thereprocase/kraken-remix-ogAMS/rings/brand-sizes/README.md

# Pentagon pairs for specific cardboard spools

Matched gear-side and cap-side centering rings for spool holes that fall between the 1 mm [stock sizes](../stock-sizes/README.md). They use the same pentagon design and the same generator; a fractional size keeps the holder bore and snap ribs of the next smaller stock ring. The five corners bite into cardboard; for hard plastic hubs use the [spring pairs](../hard-spool/README.md).

**Flange sets.** *Normal*: 2.2 mm gear-side flange and 0.6 mm cap-side lip. *Skinny*: 0.4 mm on both sides, for holders where the extra 2.0 mm of stack does not fit. humebeam's original 0.4 mm cap lip tends to break during bed removal and handling, which is why normal thickens it. The spigot of each side rises by the added base thickness, so it still inserts as deep as the stock ring.

| Nominal hole · set | Gear side | Cap side |
|---|---|---|
| 53.4 mm (Elegoo Rapid PETG cardboard spool) · normal | [3MF](models/kraken-spool-ring-53.4-mm-pentagon-gear-side-2.2mm-flange.3mf) · [STL](models/kraken-spool-ring-53.4-mm-pentagon-gear-side-2.2mm-flange.stl) · [STEP.gz](https://github.com/thereprocase/kraken-remix-ogAMS/releases/download/rings-2026-10-28/kraken-spool-ring-53.4-mm-pentagon-gear-side-2.2mm-flange.step.gz) | [3MF](models/kraken-spool-ring-53.4-mm-pentagon-cap-side-0.6mm-lip.3mf) · [STL](models/kraken-spool-ring-53.4-mm-pentagon-cap-side-0.6mm-lip.stl) · [STEP.gz](https://github.com/thereprocase/kraken-remix-ogAMS/releases/download/rings-2026-10-28/kraken-spool-ring-53.4-mm-pentagon-cap-side-0.6mm-lip.step.gz) |
| 53.4 mm · skinny | [3MF](models-skinny/kraken-spool-ring-53.4-mm-pentagon-gear-side-0.4mm-flange.3mf) · [STL](models-skinny/kraken-spool-ring-53.4-mm-pentagon-gear-side-0.4mm-flange.stl) · [STEP.gz](https://github.com/thereprocase/kraken-remix-ogAMS/releases/download/rings-2026-10-28/kraken-spool-ring-53.4-mm-pentagon-gear-side-0.4mm-flange.step.gz) | [3MF](models-skinny/kraken-spool-ring-53.4-mm-pentagon-cap-side-0.4mm-lip.3mf) · [STL](models-skinny/kraken-spool-ring-53.4-mm-pentagon-cap-side-0.4mm-lip.stl) · [STEP.gz](https://github.com/thereprocase/kraken-remix-ogAMS/releases/download/rings-2026-10-28/kraken-spool-ring-53.4-mm-pentagon-cap-side-0.4mm-lip.step.gz) |

The 55.5 mm Polymaker pair is on the [rings page](../README.md). Geometry checks: [normal](VALIDATION.json), [skinny](VALIDATION-skinny.json); each also covers the 55.5 mm pair, built in the same run. Physical fit is reported only where the table on the rings page says it was measured.
