thereprocase/kraken-remix-ogAMS/rings/round-flanges/README.md

# Round ring pairs

The earlier round centering rings: humebeam's round outer profile, with the 0.4 mm lip thickened per flange set. The gear-side flange reaches **20 mm radially beyond the hole**, wider than the later [pentagon family](../stock-sizes/README.md) with its 10.25 mm reach. The cap side keeps the lip's 2.5 mm reach. For cardboard spools the pentagon pairs grip better; for hard plastic spools use the [spring pairs](../hard-spool/README.md).

**Flange sets.** *Normal*: 2.2 mm gear-side flange and 0.6 mm cap-side lip. *Skinny*: 0.4 mm on both sides (the skinny cap side is humebeam's ring unchanged). humebeam's 0.4 mm cap lip tends to break during bed removal and handling, which is why normal thickens it.

Choose by measured spool hole. The family has not been physically fit-tested across every size. STL coordinates retain the original source placement: centre the part and move its flat flange underside onto the bed in your slicer. The model files do not contain print settings.

| Nominal hole | Normal set | Skinny set |
|---|---|---|
| 45 mm | [gear 2.2 mm](models/kraken-spool-ring-45-mm-round-gear-side-2.2mm-flange.stl) · [cap 0.6 mm](models/kraken-spool-ring-45-mm-round-cap-side-0.6mm-lip.stl) | [gear 0.4 mm](models-skinny/kraken-spool-ring-45-mm-round-gear-side-0.4mm-flange.stl) · [cap 0.4 mm](models-skinny/kraken-spool-ring-45-mm-round-cap-side-0.4mm-lip.stl) |
| 46 mm | [gear 2.2 mm](models/kraken-spool-ring-46-mm-round-gear-side-2.2mm-flange.stl) · [cap 0.6 mm](models/kraken-spool-ring-46-mm-round-cap-side-0.6mm-lip.stl) | [gear 0.4 mm](models-skinny/kraken-spool-ring-46-mm-round-gear-side-0.4mm-flange.stl) · [cap 0.4 mm](models-skinny/kraken-spool-ring-46-mm-round-cap-side-0.4mm-lip.stl) |
| 47 mm | [gear 2.2 mm](models/kraken-spool-ring-47-mm-round-gear-side-2.2mm-flange.stl) · [cap 0.6 mm](models/kraken-spool-ring-47-mm-round-cap-side-0.6mm-lip.stl) | [gear 0.4 mm](models-skinny/kraken-spool-ring-47-mm-round-gear-side-0.4mm-flange.stl) · [cap 0.4 mm](models-skinny/kraken-spool-ring-47-mm-round-cap-side-0.4mm-lip.stl) |
| 48 mm | [gear 2.2 mm](models/kraken-spool-ring-48-mm-round-gear-side-2.2mm-flange.stl) · [cap 0.6 mm](models/kraken-spool-ring-48-mm-round-cap-side-0.6mm-lip.stl) | [gear 0.4 mm](models-skinny/kraken-spool-ring-48-mm-round-gear-side-0.4mm-flange.stl) · [cap 0.4 mm](models-skinny/kraken-spool-ring-48-mm-round-cap-side-0.4mm-lip.stl) |
| 49 mm | [gear 2.2 mm](models/kraken-spool-ring-49-mm-round-gear-side-2.2mm-flange.stl) · [cap 0.6 mm](models/kraken-spool-ring-49-mm-round-cap-side-0.6mm-lip.stl) | [gear 0.4 mm](models-skinny/kraken-spool-ring-49-mm-round-gear-side-0.4mm-flange.stl) · [cap 0.4 mm](models-skinny/kraken-spool-ring-49-mm-round-cap-side-0.4mm-lip.stl) |
| 50 mm | [gear 2.2 mm](models/kraken-spool-ring-50-mm-round-gear-side-2.2mm-flange.stl) · [cap 0.6 mm](models/kraken-spool-ring-50-mm-round-cap-side-0.6mm-lip.stl) | [gear 0.4 mm](models-skinny/kraken-spool-ring-50-mm-round-gear-side-0.4mm-flange.stl) · [cap 0.4 mm](models-skinny/kraken-spool-ring-50-mm-round-cap-side-0.4mm-lip.stl) |
| 51 mm | [gear 2.2 mm](models/kraken-spool-ring-51-mm-round-gear-side-2.2mm-flange.stl) · [cap 0.6 mm](models/kraken-spool-ring-51-mm-round-cap-side-0.6mm-lip.stl) | [gear 0.4 mm](models-skinny/kraken-spool-ring-51-mm-round-gear-side-0.4mm-flange.stl) · [cap 0.4 mm](models-skinny/kraken-spool-ring-51-mm-round-cap-side-0.4mm-lip.stl) |
| 52 mm | [gear 2.2 mm](models/kraken-spool-ring-52-mm-round-gear-side-2.2mm-flange.stl) · [cap 0.6 mm](models/kraken-spool-ring-52-mm-round-cap-side-0.6mm-lip.stl) | [gear 0.4 mm](models-skinny/kraken-spool-ring-52-mm-round-gear-side-0.4mm-flange.stl) · [cap 0.4 mm](models-skinny/kraken-spool-ring-52-mm-round-cap-side-0.4mm-lip.stl) |
| 53 mm | [gear 2.2 mm](models/kraken-spool-ring-53-mm-round-gear-side-2.2mm-flange.stl) · [cap 0.6 mm](models/kraken-spool-ring-53-mm-round-cap-side-0.6mm-lip.stl) | [gear 0.4 mm](models-skinny/kraken-spool-ring-53-mm-round-gear-side-0.4mm-flange.stl) · [cap 0.4 mm](models-skinny/kraken-spool-ring-53-mm-round-cap-side-0.4mm-lip.stl) |
| 54 mm | [gear 2.2 mm](models/kraken-spool-ring-54-mm-round-gear-side-2.2mm-flange.stl) · [cap 0.6 mm](models/kraken-spool-ring-54-mm-round-cap-side-0.6mm-lip.stl) | [gear 0.4 mm](models-skinny/kraken-spool-ring-54-mm-round-gear-side-0.4mm-flange.stl) · [cap 0.4 mm](models-skinny/kraken-spool-ring-54-mm-round-cap-side-0.4mm-lip.stl) |
| 55 mm | [gear 2.2 mm](models/kraken-spool-ring-55-mm-round-gear-side-2.2mm-flange.stl) · [cap 0.6 mm](models/kraken-spool-ring-55-mm-round-cap-side-0.6mm-lip.stl) | [gear 0.4 mm](models-skinny/kraken-spool-ring-55-mm-round-gear-side-0.4mm-flange.stl) · [cap 0.4 mm](models-skinny/kraken-spool-ring-55-mm-round-cap-side-0.4mm-lip.stl) |
| 56 mm | [gear 2.2 mm](models/kraken-spool-ring-56-mm-round-gear-side-2.2mm-flange.stl) · [cap 0.6 mm](models/kraken-spool-ring-56-mm-round-cap-side-0.6mm-lip.stl) | [gear 0.4 mm](models-skinny/kraken-spool-ring-56-mm-round-gear-side-0.4mm-flange.stl) · [cap 0.4 mm](models-skinny/kraken-spool-ring-56-mm-round-cap-side-0.4mm-lip.stl) |
| 57 mm | [gear 2.2 mm](models/kraken-spool-ring-57-mm-round-gear-side-2.2mm-flange.stl) · [cap 0.6 mm](models/kraken-spool-ring-57-mm-round-cap-side-0.6mm-lip.stl) | [gear 0.4 mm](models-skinny/kraken-spool-ring-57-mm-round-gear-side-0.4mm-flange.stl) · [cap 0.4 mm](models-skinny/kraken-spool-ring-57-mm-round-cap-side-0.4mm-lip.stl) |
| 58 mm | [gear 2.2 mm](models/kraken-spool-ring-58-mm-round-gear-side-2.2mm-flange.stl) · [cap 0.6 mm](models/kraken-spool-ring-58-mm-round-cap-side-0.6mm-lip.stl) | [gear 0.4 mm](models-skinny/kraken-spool-ring-58-mm-round-gear-side-0.4mm-flange.stl) · [cap 0.4 mm](models-skinny/kraken-spool-ring-58-mm-round-cap-side-0.4mm-lip.stl) |
| 59 mm | [gear 2.2 mm](models/kraken-spool-ring-59-mm-round-gear-side-2.2mm-flange.stl) · [cap 0.6 mm](models/kraken-spool-ring-59-mm-round-cap-side-0.6mm-lip.stl) | [gear 0.4 mm](models-skinny/kraken-spool-ring-59-mm-round-gear-side-0.4mm-flange.stl) · [cap 0.4 mm](models-skinny/kraken-spool-ring-59-mm-round-cap-side-0.4mm-lip.stl) |
| 60 mm | [gear 2.2 mm](models/kraken-spool-ring-60-mm-round-gear-side-2.2mm-flange.stl) · [cap 0.6 mm](models/kraken-spool-ring-60-mm-round-cap-side-0.6mm-lip.stl) | [gear 0.4 mm](models-skinny/kraken-spool-ring-60-mm-round-gear-side-0.4mm-flange.stl) · [cap 0.4 mm](models-skinny/kraken-spool-ring-60-mm-round-cap-side-0.4mm-lip.stl) |
| 61 mm | [gear 2.2 mm](models/kraken-spool-ring-61-mm-round-gear-side-2.2mm-flange.stl) · [cap 0.6 mm](models/kraken-spool-ring-61-mm-round-cap-side-0.6mm-lip.stl) | [gear 0.4 mm](models-skinny/kraken-spool-ring-61-mm-round-gear-side-0.4mm-flange.stl) · [cap 0.4 mm](models-skinny/kraken-spool-ring-61-mm-round-cap-side-0.4mm-lip.stl) |
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
| 90 mm | [gear 2.2 mm](models/kraken-spool-ring-90-mm-round-gear-side-2.2mm-flange.stl) · [cap 0.6 mm](models/kraken-spool-ring-90-mm-round-cap-side-0.6mm-lip.stl) | [gear 0.4 mm](models-skinny/kraken-spool-ring-90-mm-round-gear-side-0.4mm-flange.stl) · [cap 0.4 mm](models-skinny/kraken-spool-ring-90-mm-round-cap-side-0.4mm-lip.stl) |
| 91 mm | [gear 2.2 mm](models/kraken-spool-ring-91-mm-round-gear-side-2.2mm-flange.stl) · [cap 0.6 mm](models/kraken-spool-ring-91-mm-round-cap-side-0.6mm-lip.stl) | [gear 0.4 mm](models-skinny/kraken-spool-ring-91-mm-round-gear-side-0.4mm-flange.stl) · [cap 0.4 mm](models-skinny/kraken-spool-ring-91-mm-round-cap-side-0.4mm-lip.stl) |
| 92 mm | [gear 2.2 mm](models/kraken-spool-ring-92-mm-round-gear-side-2.2mm-flange.stl) · [cap 0.6 mm](models/kraken-spool-ring-92-mm-round-cap-side-0.6mm-lip.stl) | [gear 0.4 mm](models-skinny/kraken-spool-ring-92-mm-round-gear-side-0.4mm-flange.stl) · [cap 0.4 mm](models-skinny/kraken-spool-ring-92-mm-round-cap-side-0.4mm-lip.stl) |
| 93 mm | [gear 2.2 mm](models/kraken-spool-ring-93-mm-round-gear-side-2.2mm-flange.stl) · [cap 0.6 mm](models/kraken-spool-ring-93-mm-round-cap-side-0.6mm-lip.stl) | [gear 0.4 mm](models-skinny/kraken-spool-ring-93-mm-round-gear-side-0.4mm-flange.stl) · [cap 0.4 mm](models-skinny/kraken-spool-ring-93-mm-round-cap-side-0.4mm-lip.stl) |
| 94 mm | [gear 2.2 mm](models/kraken-spool-ring-94-mm-round-gear-side-2.2mm-flange.stl) · [cap 0.6 mm](models/kraken-spool-ring-94-mm-round-cap-side-0.6mm-lip.stl) | [gear 0.4 mm](models-skinny/kraken-spool-ring-94-mm-round-gear-side-0.4mm-flange.stl) · [cap 0.4 mm](models-skinny/kraken-spool-ring-94-mm-round-cap-side-0.4mm-lip.stl) |
| 95 mm | [gear 2.2 mm](models/kraken-spool-ring-95-mm-round-gear-side-2.2mm-flange.stl) · [cap 0.6 mm](models/kraken-spool-ring-95-mm-round-cap-side-0.6mm-lip.stl) | [gear 0.4 mm](models-skinny/kraken-spool-ring-95-mm-round-gear-side-0.4mm-flange.stl) · [cap 0.4 mm](models-skinny/kraken-spool-ring-95-mm-round-cap-side-0.4mm-lip.stl) |

Bulk downloads: [normal set ZIP](https://github.com/thereprocase/kraken-remix-ogAMS/releases/download/rings-2026-10-28/kraken-spool-rings-round-normal-stl.zip) · [skinny set ZIP](https://github.com/thereprocase/kraken-remix-ogAMS/releases/download/rings-2026-10-28/kraken-spool-rings-round-skinny-stl.zip).

## Reproduction

[Validation](VALIDATION.json) checks all 204 meshes as single closed solids. From the repository root, using its CAD dependencies:

```sh
python rings/source/round_flange.py rings/source/reference round-build normal
python rings/source/round_flange.py rings/source/reference round-skinny-build skinny
```

The script remaps humebeam's mesh in place: heights 0–0.4 mm stretch to the new base thickness, everything above moves up by the difference, and gear-side lip vertices move outward to the 20 mm reach. It does not scale the holder bore radially. At 1.5 mm the same remap reproduces the earlier published gear-side files byte for byte apart from the STL header. Original meshes are attributed in the [source notes](../source/README.md). The changed flange does not by itself prove increased gear-to-body clearance.

Original design: **humebeam**; remix: **thereprocase**. [CC BY-NC 4.0](../../LICENSE.md).
