thereprocase/kraken-remix-ogAMS/reloadable-spool/renders/exploded.png

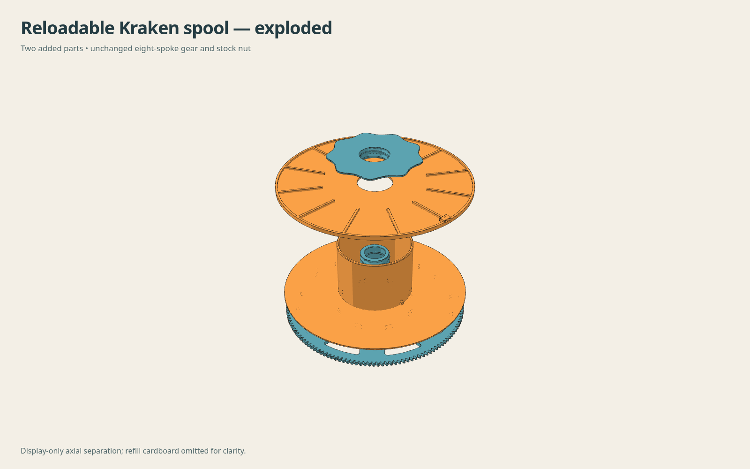
reloadable-spool/renders/exploded.png
