thereprocase/kraken-remix-ogAMS/models/left-body-standard_full.step

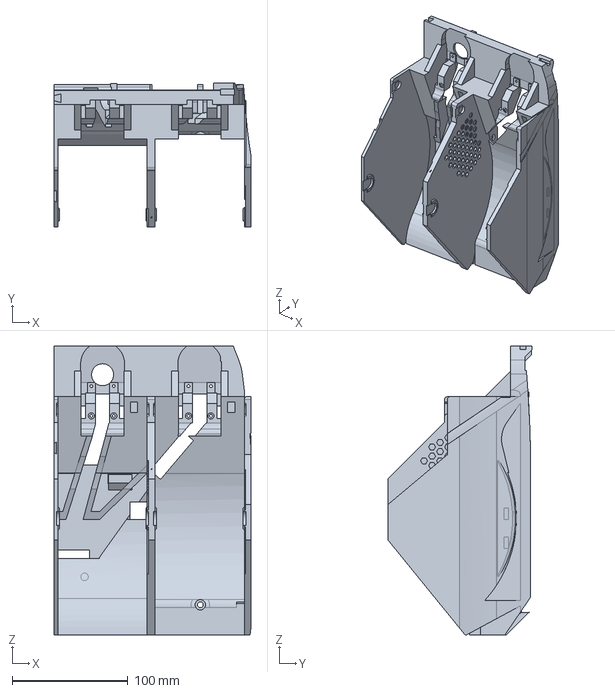
[picture p10: CAD file, 2026-10-16]
models/left-body-standard_full.step
170.2 x 124.8 x 249.9 mm
