thereprocase/kraken-remix-ogAMS/reloadable-spool/artifacts/assembly-reference-NOT-FOR-PRINT.3mf

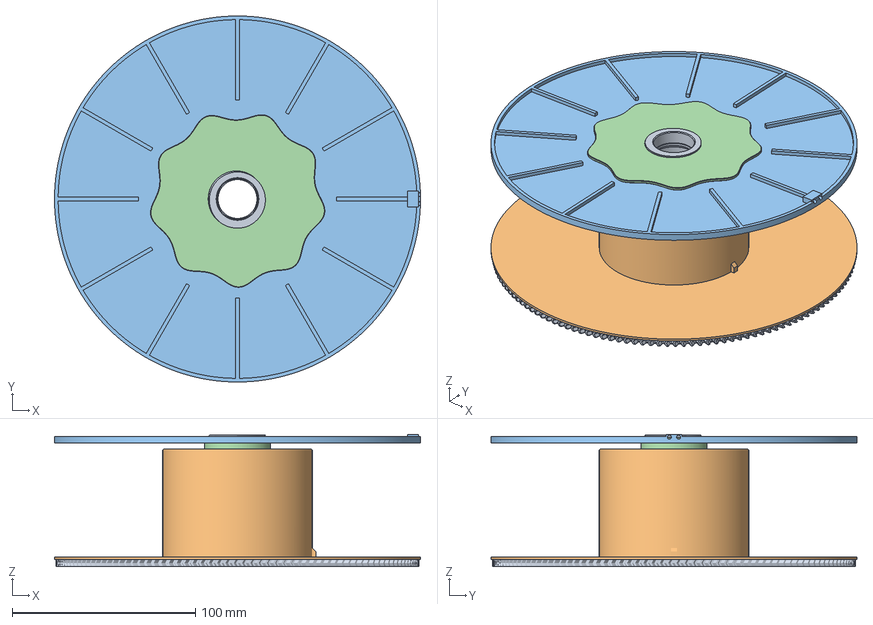
[picture p11: CAD file, 2026-10-17]
reloadable-spool/artifacts/assembly-reference-NOT-FOR-PRINT.3mf
200.0 x 200.0 x 72.4 mm
retained-eight-spoke-gear
backing-sleeve
removable-flange
retained-stock-nut
