thereprocase/kraken-remix-ogAMS/reloadable-spool/artifacts/added-parts-assembly.step

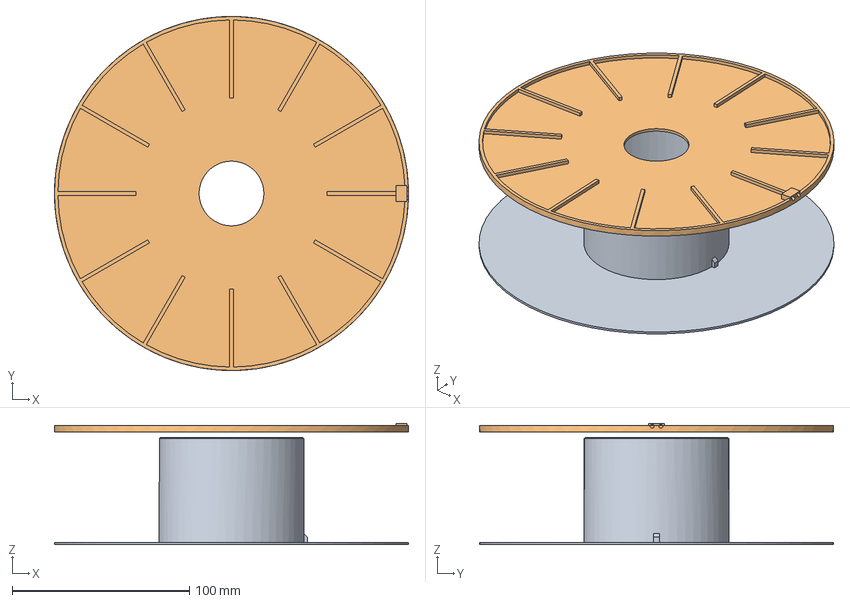
[picture p12: CAD file, 2026-10-17]
reloadable-spool/artifacts/added-parts-assembly.step
200.0 x 199.9 x 68.4 mm
