thereprocase/kraken-remix-ogAMS/prints/pctg-2026-10-28-v5/left-front-bar-v5-assembly.step

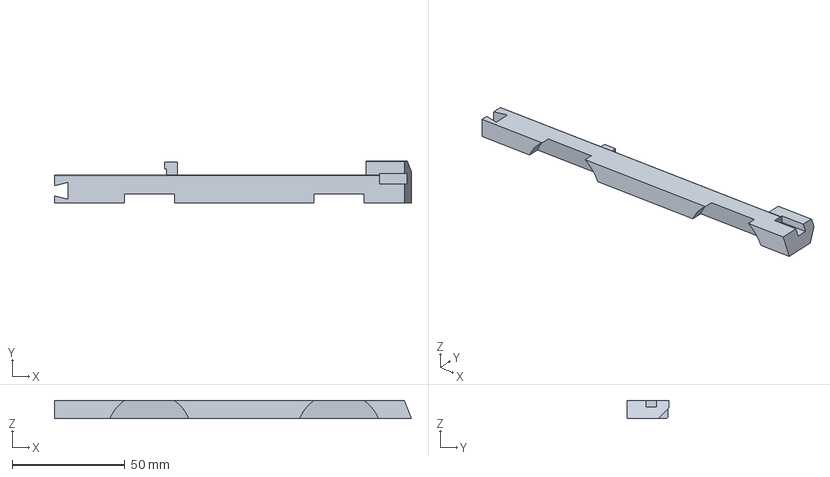
[picture p13: CAD file, 2026-10-28]
prints/pctg-2026-10-28-v5/left-front-bar-v5-assembly.step
158.1 x 18.7 x 8.00 mm
