thereprocase/kraken-remix-ogAMS/models/right-body-standard_full.step

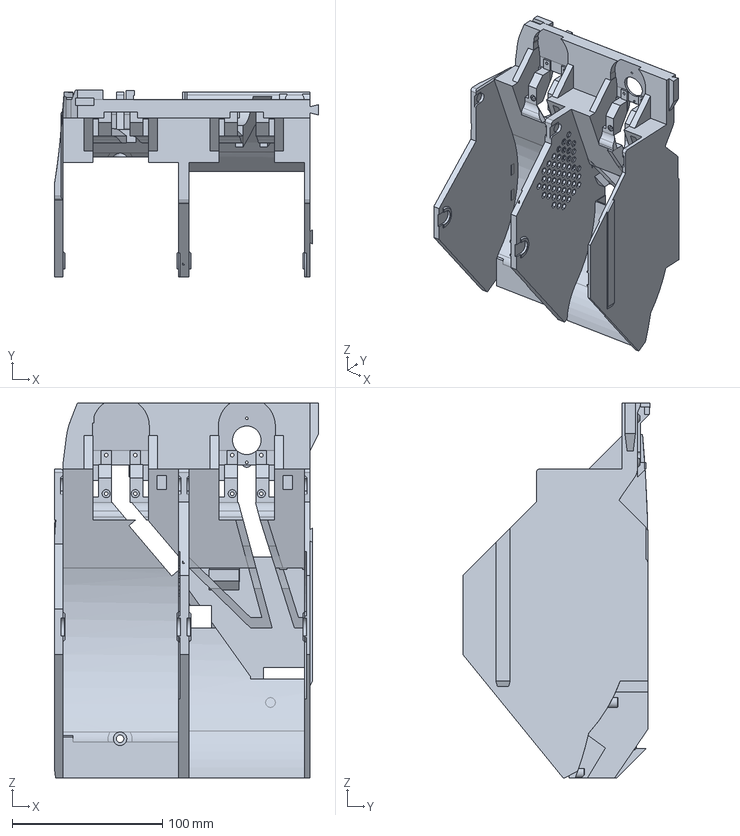
[picture p14: CAD file, 2026-10-16]
models/right-body-standard_full.step
176.1 x 124.8 x 249.9 mm
