thereprocase/kraken-remix-ogAMS/coupons/cut5_alignment84/artifacts/right_sockets_84_nominal.step

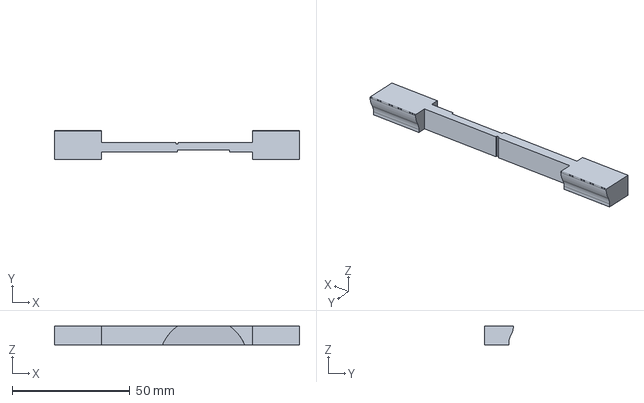
[picture p15: CAD file, 2026-10-16]
coupons/cut5_alignment84/artifacts/right_sockets_84_nominal.step
104.0 x 12.4 x 8.00 mm
