thereprocase/kraken-remix-ogAMS/coupons/cut5_fit/artifacts/key_common.step

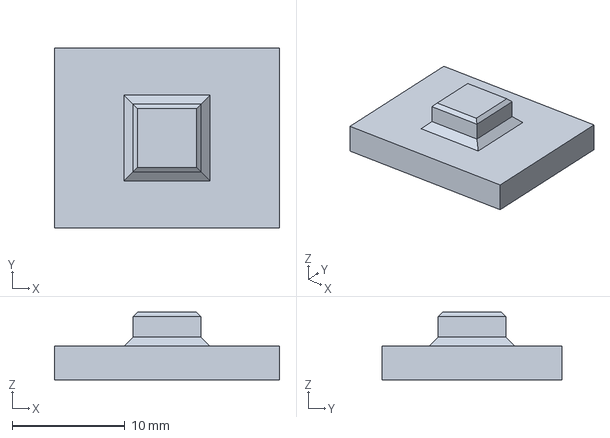
[picture p16: CAD file, 2026-10-16]
coupons/cut5_fit/artifacts/key_common.step
20.0 x 16.0 x 6.00 mm
