thereprocase/kraken-remix-ogAMS/gear/models/gear-spokes.3mf

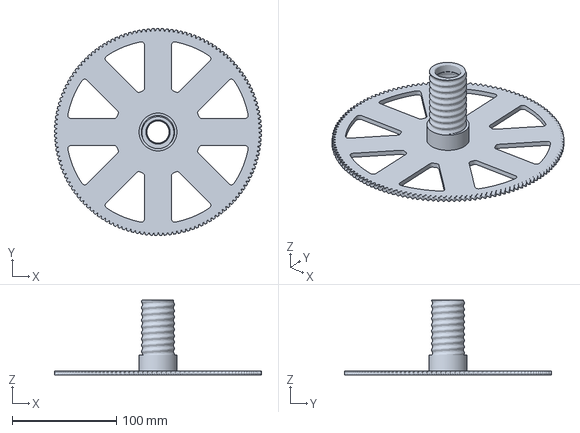
[picture p17: CAD file, 2026-10-15]
gear/models/gear-spokes.3mf
198.6 x 198.6 x 71.9 mm
