thereprocase/kraken-remix-ogAMS/models/right-body-standard_cut5.step

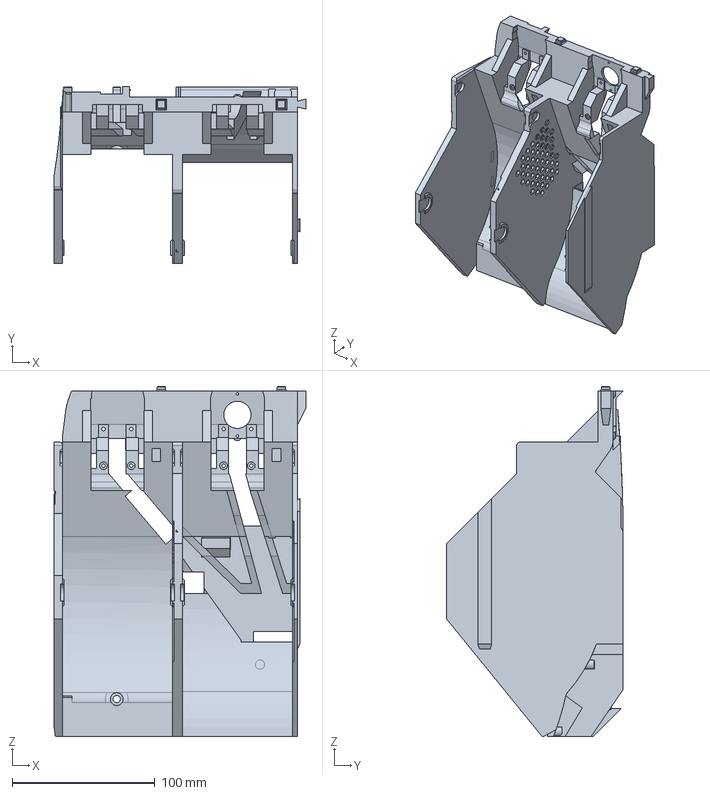
[picture p18: CAD file, 2026-10-16]
models/right-body-standard_cut5.step
176.1 x 123.8 x 244.9 mm
