thereprocase/kraken-remix-ogAMS/reloadable-spool/artifacts/removable-flange.step

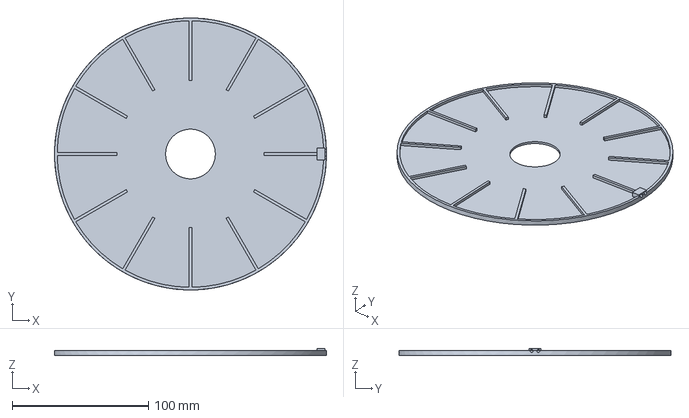
[picture p19: CAD file, 2026-10-17]
reloadable-spool/artifacts/removable-flange.step
200.0 x 200.0 x 4.80 mm
