thereprocase/kraken-remix-ogAMS/reloadable-spool/revisions/uniform-flange-6mm/artifacts/backing-sleeve-keyless-installed.step

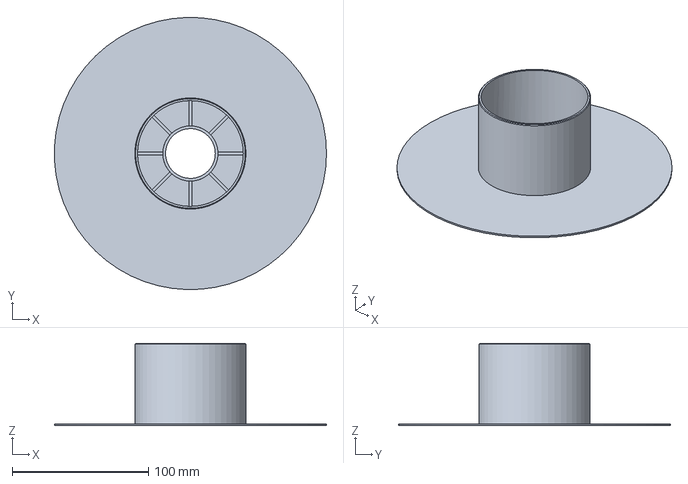
[picture p20: CAD file, 2026-10-17]
reloadable-spool/revisions/uniform-flange-6mm/artifacts/backing-sleeve-keyless-installed.step
199.9 x 199.9 x 60.4 mm
