thereprocase/kraken-remix-ogAMS/rings/brand-sizes/models-skinny/kraken-spool-ring-53.4-mm-pentagon-gear-side-0.4mm-flange.3mf

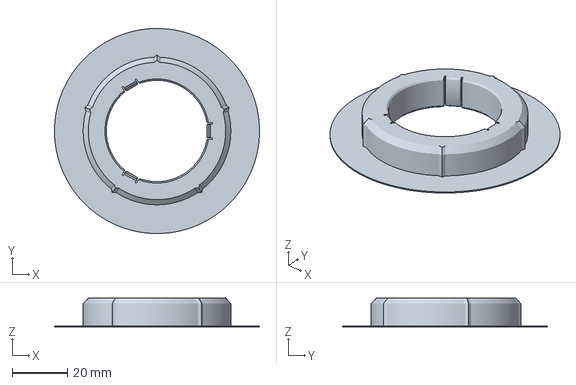
[picture p21: CAD file, 2026-10-28]
rings/brand-sizes/models-skinny/kraken-spool-ring-53.4-mm-pentagon-gear-side-0.4mm-flange.3mf
73.9 x 73.9 x 10.4 mm
