thereprocase/kraken-remix-ogAMS/rings/brand-sizes/models/kraken-spool-ring-53.4-mm-pentagon-cap-side-0.6mm-lip.3mf

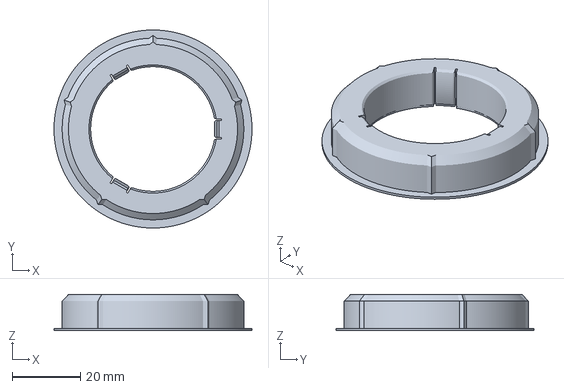
[picture p22: CAD file, 2026-10-28]
rings/brand-sizes/models/kraken-spool-ring-53.4-mm-pentagon-cap-side-0.6mm-lip.3mf
58.0 x 58.0 x 10.6 mm
