thereprocase/kraken-remix-ogAMS/rings/hard-spool/models-skinny/kraken-spool-ring-52.1-mm-spring-cap-side-0.4mm-lip.3mf

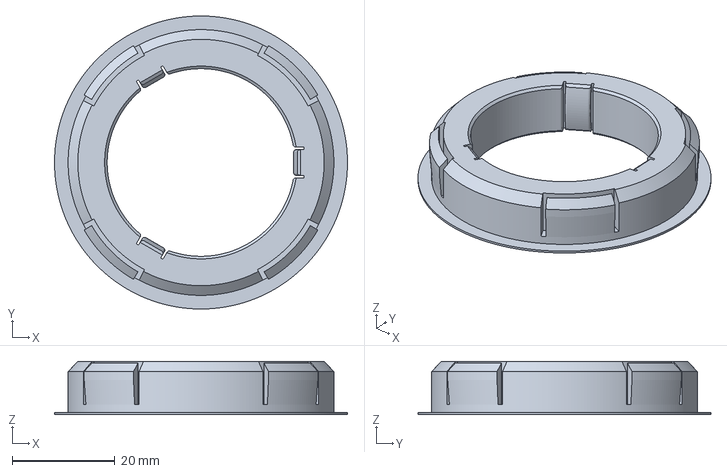
[picture p23: CAD file, 2026-10-28]
rings/hard-spool/models-skinny/kraken-spool-ring-52.1-mm-spring-cap-side-0.4mm-lip.3mf
57.0 x 57.0 x 10.4 mm
