thereprocase/kraken-remix-ogAMS/rings/models-skinny/kraken-spool-ring-55.5-mm-pentagon-cap-side-0.4mm-lip.3mf

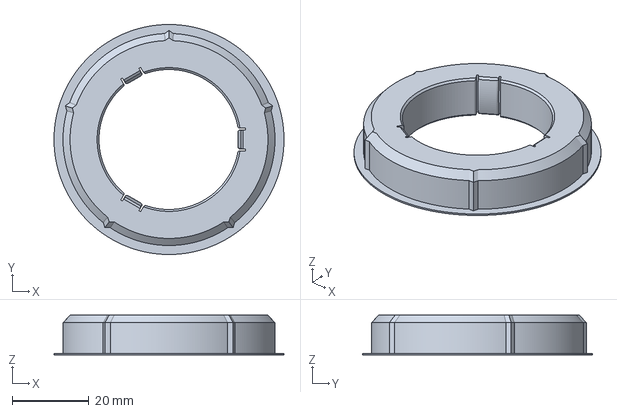
[picture p25: CAD file, 2026-10-28]
rings/models-skinny/kraken-spool-ring-55.5-mm-pentagon-cap-side-0.4mm-lip.3mf
60.0 x 60.0 x 10.4 mm
