thereprocase/kraken-remix-ogAMS/rings/models/kraken-spool-ring-55.5-mm-pentagon-gear-side-2.2mm-flange.3mf

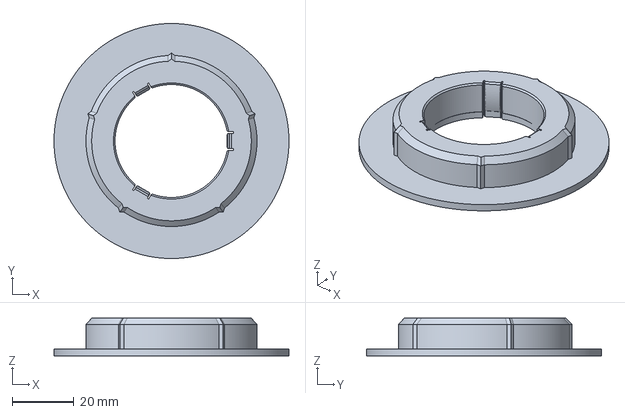
[picture p26: CAD file, 2026-10-28]
rings/models/kraken-spool-ring-55.5-mm-pentagon-gear-side-2.2mm-flange.3mf
76.0 x 76.0 x 12.2 mm
