thereprocase/kraken-remix-ogAMS/rings/round-flanges/models/kraken-spool-ring-56-mm-round-cap-side-0.6mm-lip.stl

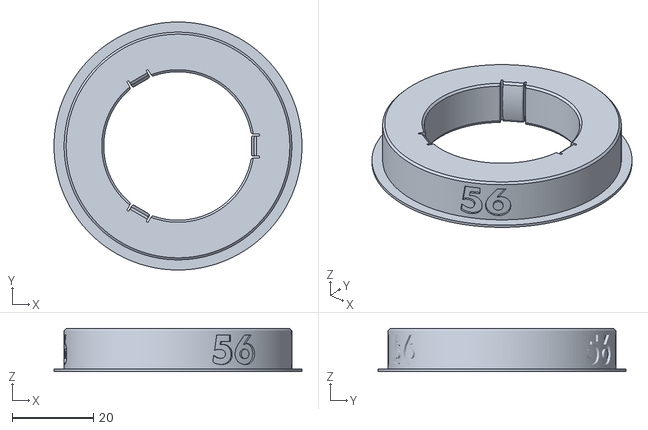
[picture p28: CAD file, 2026-10-28]
rings/round-flanges/models/kraken-spool-ring-56-mm-round-cap-side-0.6mm-lip.stl
61.0 x 61.0 x 10.6
