thereprocase/kraken-remix-ogAMS/rings/source/reference/kraken-spool-ring-94-mm-100.3mf

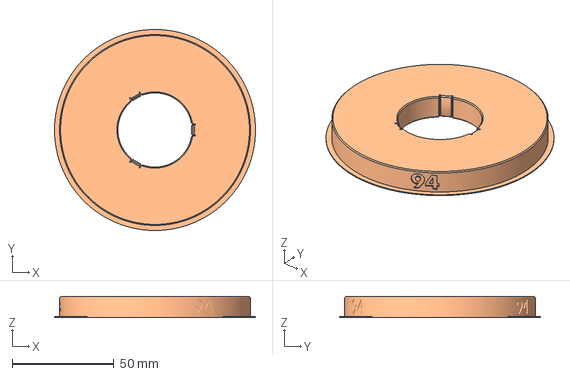
[picture p29: CAD file, 2026-10-16]
rings/source/reference/kraken-spool-ring-94-mm-100.3mf
99.0 x 99.0 x 10.4 mm
