thereprocase/kraken-remix-ogAMS/rings/stock-sizes/models-skinny/kraken-spool-ring-69-mm-pentagon-gear-side-0.4mm-flange.3mf

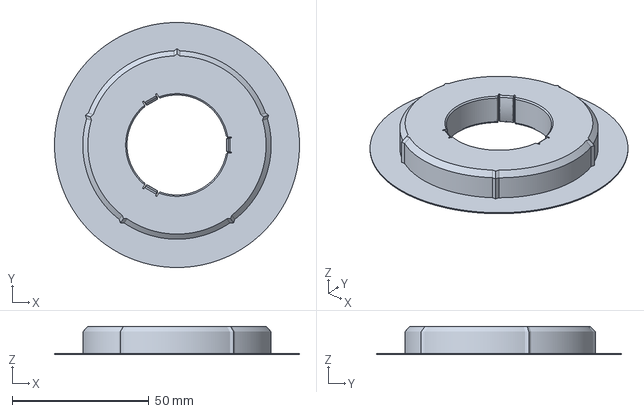
[picture p30: CAD file, 2026-10-28]
rings/stock-sizes/models-skinny/kraken-spool-ring-69-mm-pentagon-gear-side-0.4mm-flange.3mf
89.5 x 89.5 x 10.4 mm
