thereprocase/kraken-remix-ogAMS/coupons/cut5_alignment84/artifacts/right_keys_84_nominal.step

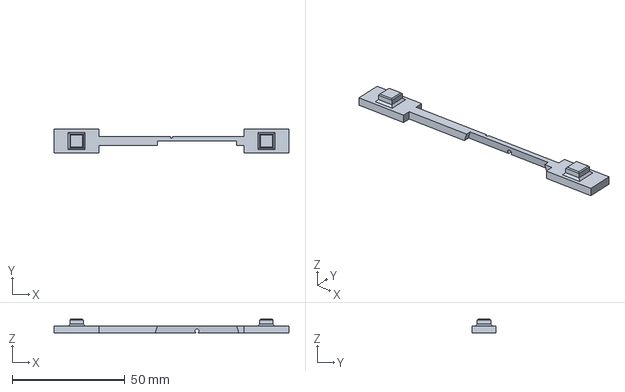
[picture p32: CAD file, 2026-10-16]
coupons/cut5_alignment84/artifacts/right_keys_84_nominal.step
104.0 x 10.4 x 6.00 mm
