thereprocase/kraken-remix-ogAMS/coupons/cut5_fit/artifacts/socket_2_c015_nominal.step

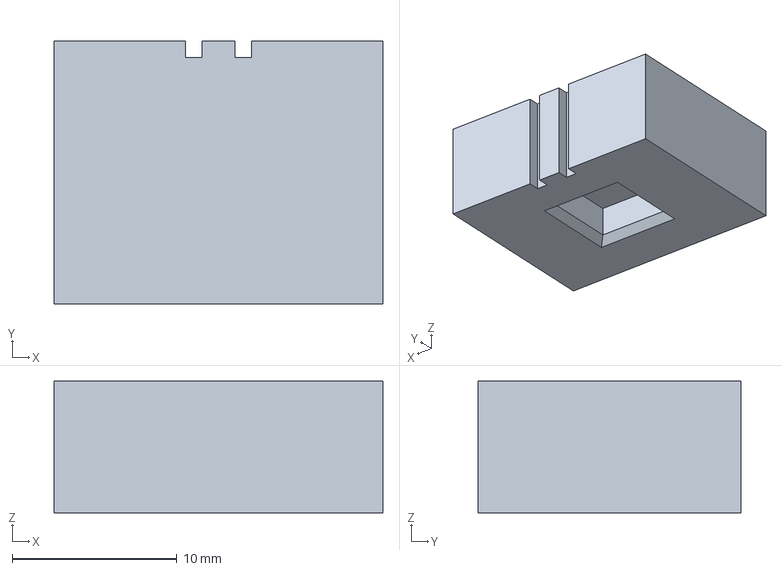
[picture p33: CAD file, 2026-10-16]
coupons/cut5_fit/artifacts/socket_2_c015_nominal.step
20.0 x 16.0 x 8.00 mm
