thereprocase/kraken-remix-ogAMS/gear/models/gear-spokes-analytic-web.step

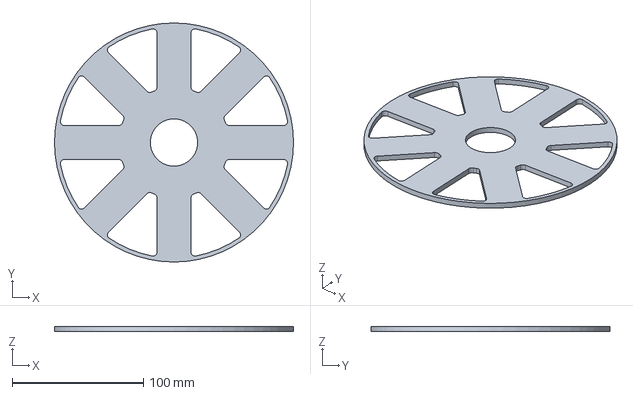
[picture p34: CAD file, 2026-10-15]
gear/models/gear-spokes-analytic-web.step
182.0 x 182.0 x 4.00 mm
