thereprocase/kraken-remix-ogAMS/prints/asa-2026-10-16/left-body-v4-model.3mf

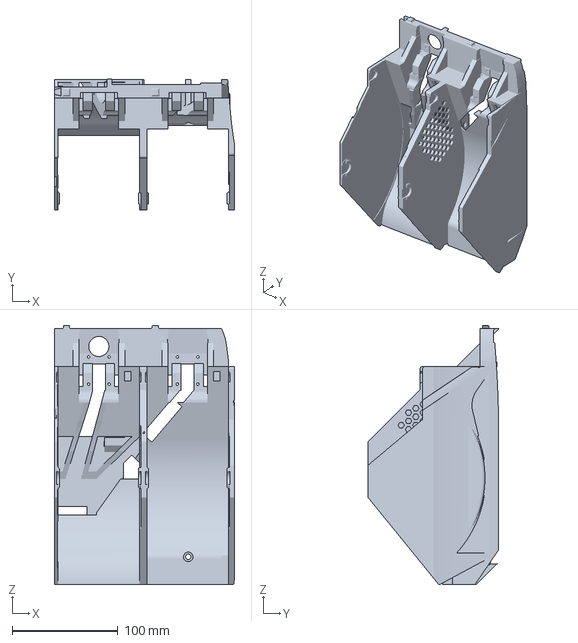
[picture p35: CAD file, 2026-10-16]
prints/asa-2026-10-16/left-body-v4-model.3mf
170.2 x 123.8 x 244.9 mm
