thereprocase/kraken-remix-ogAMS/rings/brand-sizes/models-skinny/kraken-spool-ring-53.4-mm-pentagon-cap-side-0.4mm-lip.3mf

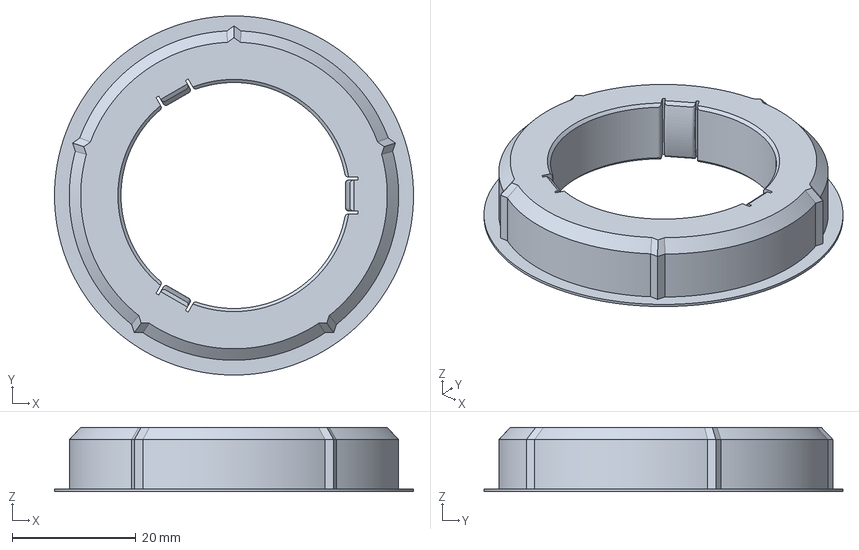
[picture p36: CAD file, 2026-10-24]
rings/brand-sizes/models-skinny/kraken-spool-ring-53.4-mm-pentagon-cap-side-0.4mm-lip.3mf
58.0 x 58.0 x 10.4 mm
