thereprocase/kraken-remix-ogAMS/rings/brand-sizes/models/kraken-spool-ring-53.4-mm-pentagon-gear-side-2.2mm-flange.3mf

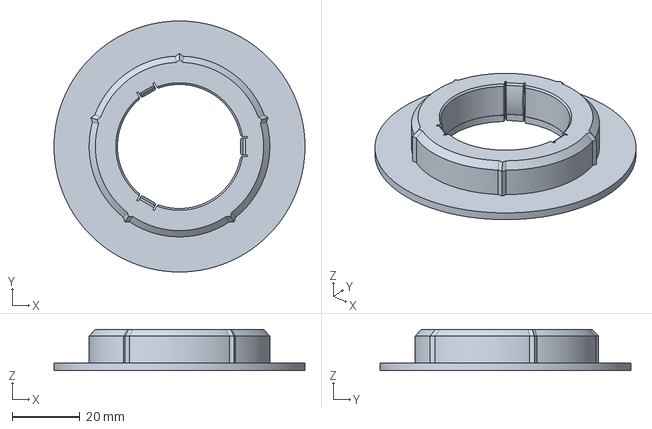
[picture p37: CAD file, 2026-10-28]
rings/brand-sizes/models/kraken-spool-ring-53.4-mm-pentagon-gear-side-2.2mm-flange.3mf
73.9 x 73.9 x 12.2 mm
