thereprocase/kraken-remix-ogAMS/rings/hard-spool/models/kraken-spool-ring-52.1-mm-spring-gear-side-2.2mm-flange.3mf

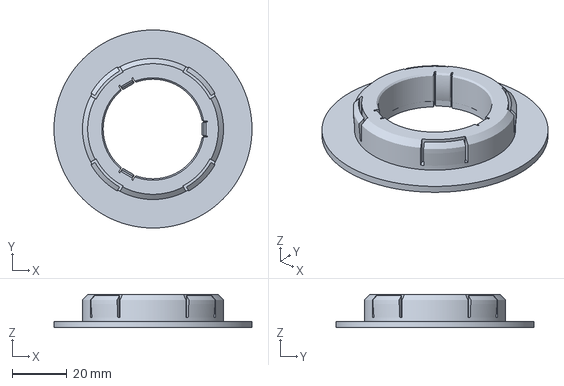
[picture p38: CAD file, 2026-10-28]
rings/hard-spool/models/kraken-spool-ring-52.1-mm-spring-gear-side-2.2mm-flange.3mf
72.6 x 72.6 x 12.2 mm
