thereprocase/kraken-remix-ogAMS/rings/models-skinny/kraken-spool-ring-55.5-mm-pentagon-gear-side-0.4mm-flange.3mf

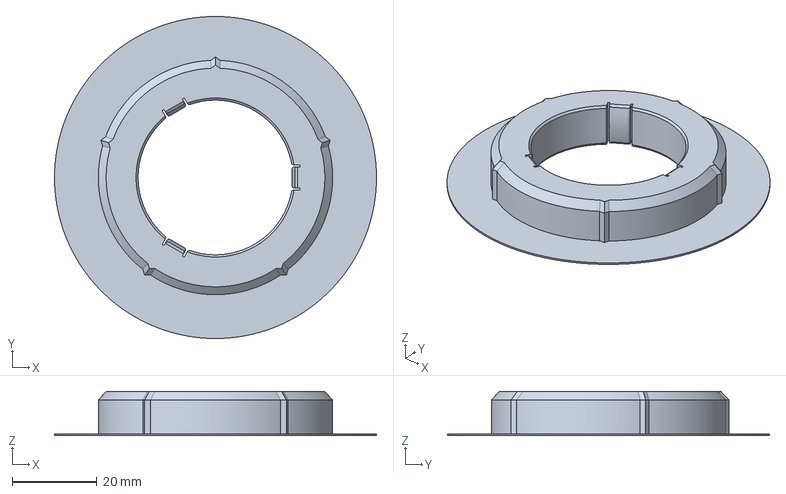
[picture p39: CAD file, 2026-10-28]
rings/models-skinny/kraken-spool-ring-55.5-mm-pentagon-gear-side-0.4mm-flange.3mf
76.0 x 76.0 x 10.4 mm
