thereprocase/kraken-remix-ogAMS/rings/models/kraken-spool-ring-55.5-mm-pentagon-cap-side-0.6mm-lip.3mf

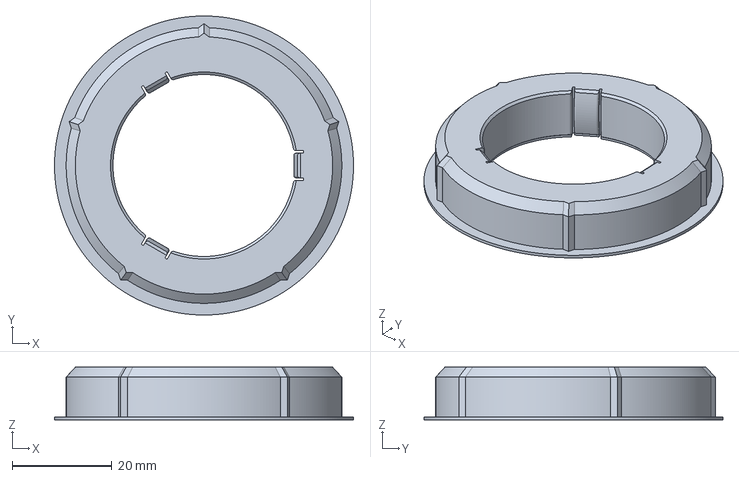
[picture p40: CAD file, 2026-10-28]
rings/models/kraken-spool-ring-55.5-mm-pentagon-cap-side-0.6mm-lip.3mf
60.0 x 60.0 x 10.6 mm
