thereprocase/kraken-remix-ogAMS/rings/round-flanges/models-skinny/kraken-spool-ring-58-mm-round-cap-side-0.4mm-lip.stl

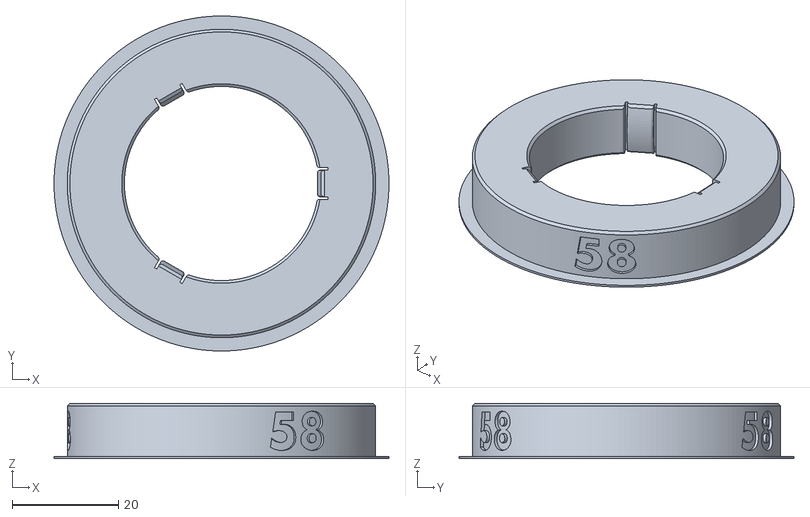
[picture p41: CAD file, 2026-10-28]
rings/round-flanges/models-skinny/kraken-spool-ring-58-mm-round-cap-side-0.4mm-lip.stl
63.0 x 63.0 x 10.4
