thereprocase/kraken-remix-ogAMS/rings/round-flanges/models/kraken-spool-ring-46-mm-round-cap-side-0.6mm-lip.stl

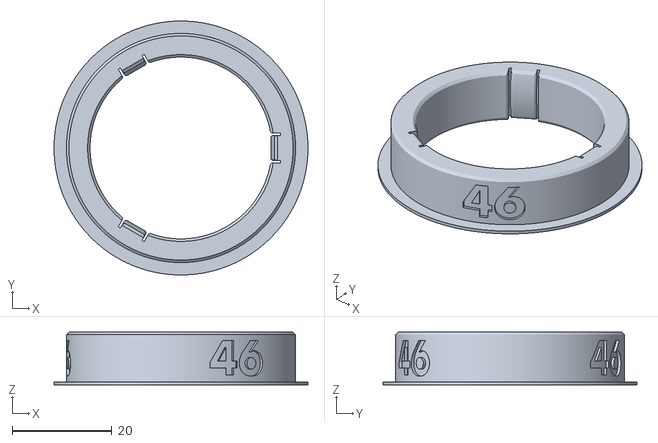
[picture p42: CAD file, 2026-10-28]
rings/round-flanges/models/kraken-spool-ring-46-mm-round-cap-side-0.6mm-lip.stl
51.0 x 51.0 x 10.6
