thereprocase/kraken-remix-ogAMS/rings/source/reference/kraken-spool-ring-51-mm-100.3mf

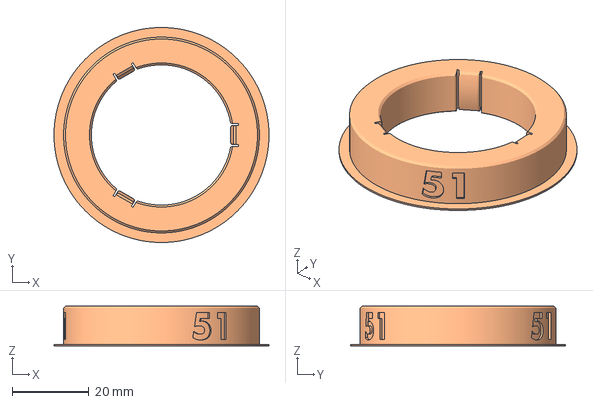
[picture p43: CAD file, 2026-10-16]
rings/source/reference/kraken-spool-ring-51-mm-100.3mf
56.0 x 56.0 x 10.4 mm
