thereprocase/kraken-remix-ogAMS/rings/stock-sizes/models/kraken-spool-ring-65-mm-pentagon-cap-side-0.6mm-lip.3mf

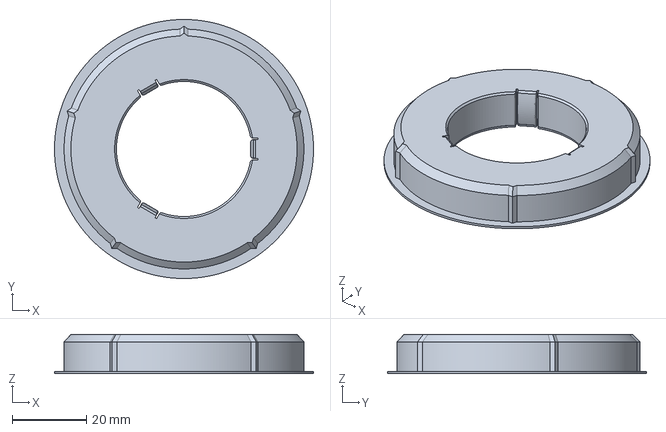
[picture p45: CAD file, 2026-10-28]
rings/stock-sizes/models/kraken-spool-ring-65-mm-pentagon-cap-side-0.6mm-lip.3mf
70.0 x 70.0 x 10.6 mm
