thereprocase/kraken-remix-ogAMS/rings/round-flanges/models-skinny/kraken-spool-ring-69-mm-round-gear-side-0.4mm-flange.stl

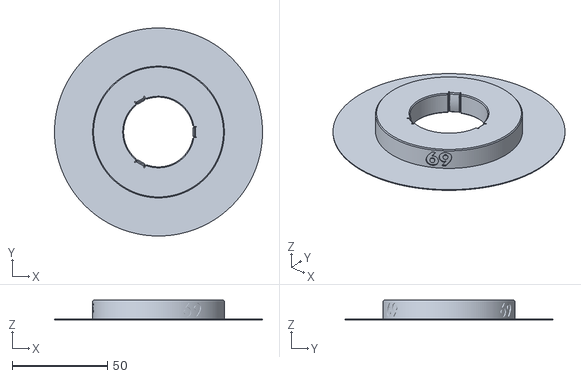
[picture p48: CAD file, 2026-10-28]
rings/round-flanges/models-skinny/kraken-spool-ring-69-mm-round-gear-side-0.4mm-flange.stl
109.0 x 109.0 x 10.4
