thereprocase/kraken-remix-ogAMS/rings/round-flanges/models/kraken-spool-ring-71-mm-round-gear-side-2.2mm-flange.stl

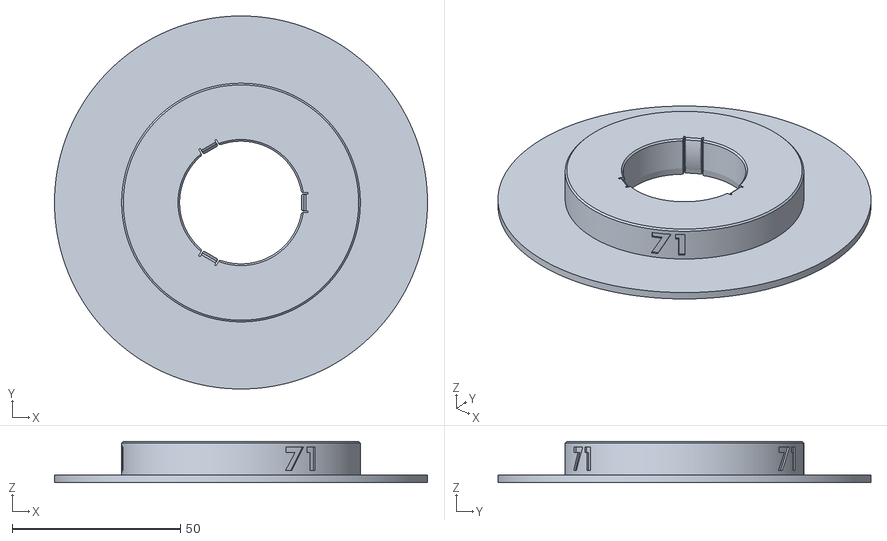
[picture p49: CAD file, 2026-10-28]
rings/round-flanges/models/kraken-spool-ring-71-mm-round-gear-side-2.2mm-flange.stl
111.0 x 111.0 x 12.2
