thereprocase/kraken-remix-ogAMS/rings/source/reference/kraken-spool-ring-66-mm-100.3mf

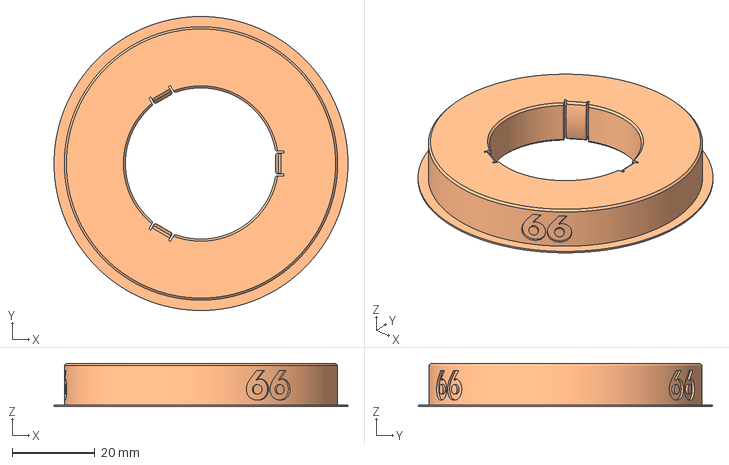
[picture p50: CAD file, 2026-10-16]
rings/source/reference/kraken-spool-ring-66-mm-100.3mf
71.0 x 71.0 x 10.4 mm
