thereprocase/kraken-remix-ogAMS/rings/stock-sizes/models-skinny/kraken-spool-ring-68-mm-pentagon-gear-side-0.4mm-flange.3mf

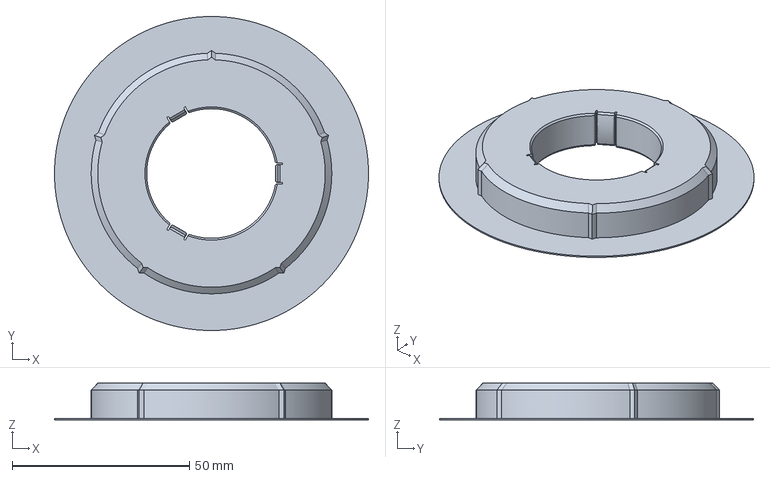
[picture p51: CAD file, 2026-10-28]
rings/stock-sizes/models-skinny/kraken-spool-ring-68-mm-pentagon-gear-side-0.4mm-flange.3mf
88.5 x 88.5 x 10.4 mm
