thereprocase/kraken-remix-ogAMS/rings/stock-sizes/models/kraken-spool-ring-84-mm-pentagon-cap-side-0.6mm-lip.3mf

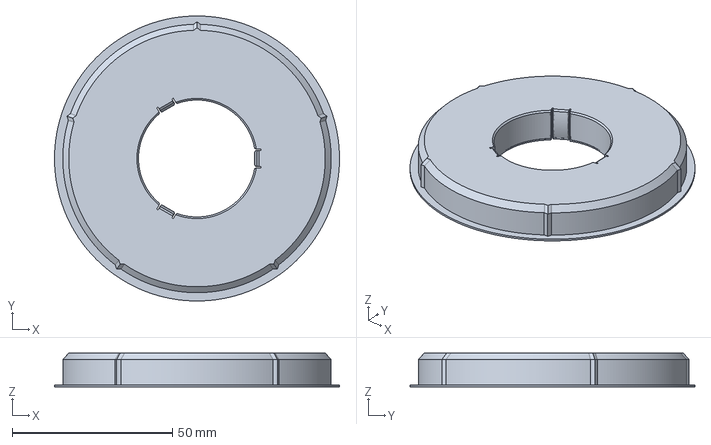
[picture p52: CAD file, 2026-10-28]
rings/stock-sizes/models/kraken-spool-ring-84-mm-pentagon-cap-side-0.6mm-lip.3mf
89.0 x 89.0 x 10.6 mm
