thereprocase/kraken-remix-ogAMS/reloadable-spool/revisions/uniform-flange-6mm/artifacts/removable-flange-stiff-annulus.step

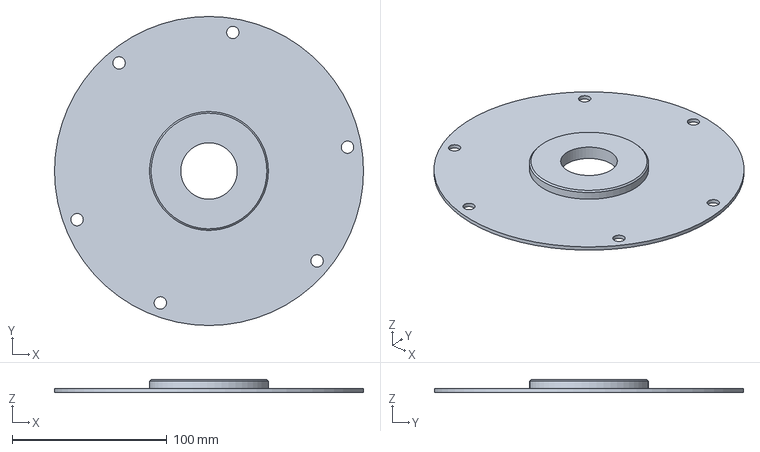
[picture p54: CAD file, 2026-10-17]
reloadable-spool/revisions/uniform-flange-6mm/artifacts/removable-flange-stiff-annulus.step
200.0 x 200.0 x 8.45 mm
