thereprocase/kraken-remix-ogAMS/rings/round-flanges/models-skinny/kraken-spool-ring-64-mm-round-cap-side-0.4mm-lip.stl

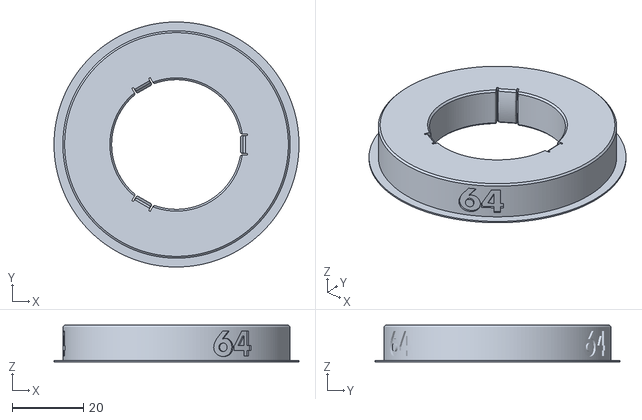
[picture p55: CAD file, 2026-10-28]
rings/round-flanges/models-skinny/kraken-spool-ring-64-mm-round-cap-side-0.4mm-lip.stl
69.0 x 69.0 x 10.4
