thereprocase/kraken-remix-ogAMS/rings/round-flanges/models/kraken-spool-ring-84-mm-round-gear-side-2.2mm-flange.stl

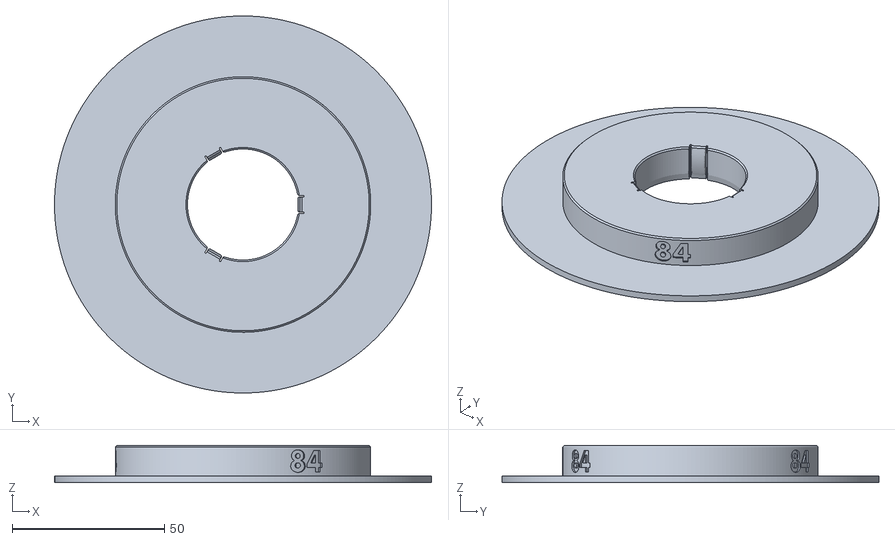
[picture p56: CAD file, 2026-10-28]
rings/round-flanges/models/kraken-spool-ring-84-mm-round-gear-side-2.2mm-flange.stl
124.0 x 124.0 x 12.2
