thereprocase/kraken-remix-ogAMS/rings/source/reference/kraken-spool-ring-87-mm-100.3mf

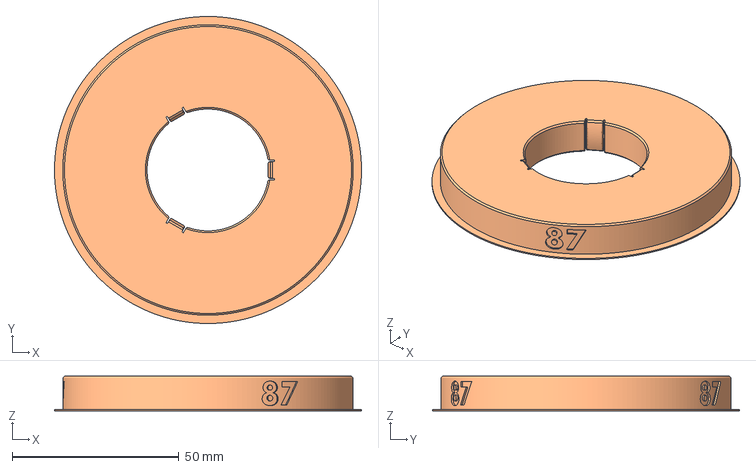
[picture p57: CAD file, 2026-10-16]
rings/source/reference/kraken-spool-ring-87-mm-100.3mf
92.0 x 92.0 x 10.4 mm
