thereprocase/kraken-remix-ogAMS/rings/stock-sizes/models-skinny/kraken-spool-ring-78-mm-pentagon-gear-side-0.4mm-flange.3mf

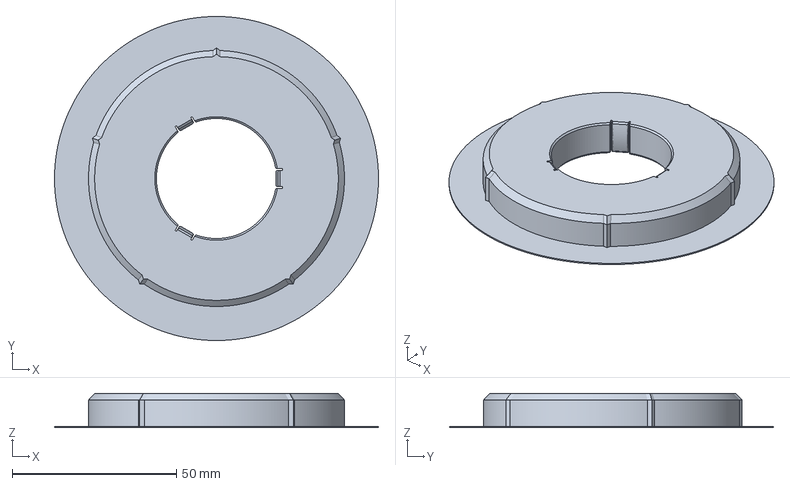
[picture p58: CAD file, 2026-10-28]
rings/stock-sizes/models-skinny/kraken-spool-ring-78-mm-pentagon-gear-side-0.4mm-flange.3mf
98.5 x 98.5 x 10.4 mm
