thereprocase/kraken-remix-ogAMS/rings/round-flanges/models-skinny/kraken-spool-ring-46-mm-round-gear-side-0.4mm-flange.stl

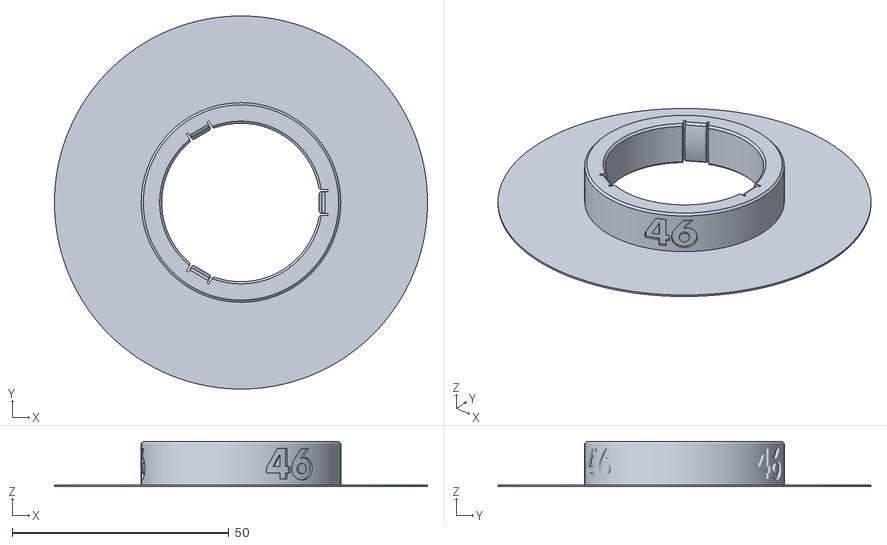
[picture p60: CAD file, 2026-10-28]
rings/round-flanges/models-skinny/kraken-spool-ring-46-mm-round-gear-side-0.4mm-flange.stl
86.0 x 86.0 x 10.4
