thereprocase/kraken-remix-ogAMS/rings/source/reference/kraken-spool-ring-81-mm-100.3mf

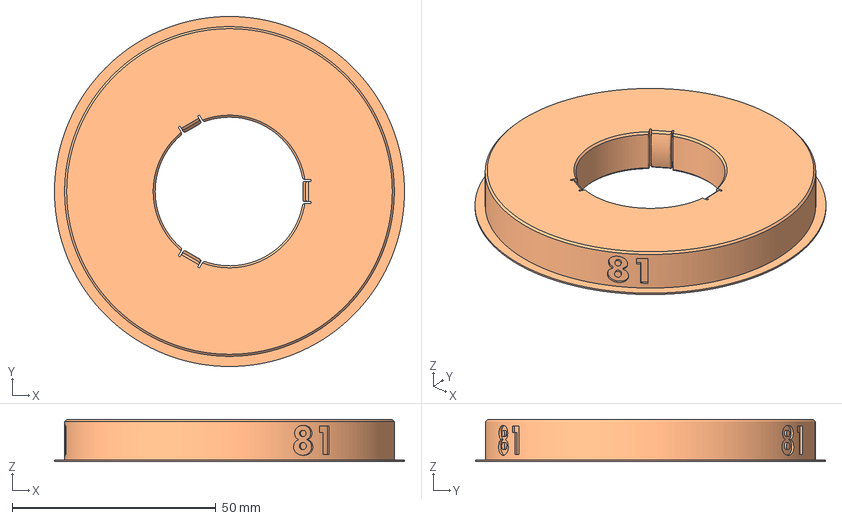
[picture p61: CAD file, 2026-10-16]
rings/source/reference/kraken-spool-ring-81-mm-100.3mf
86.0 x 86.0 x 10.4 mm
