thereprocase/kraken-remix-ogAMS/rings/stock-sizes/models/kraken-spool-ring-76-mm-pentagon-gear-side-2.2mm-flange.3mf

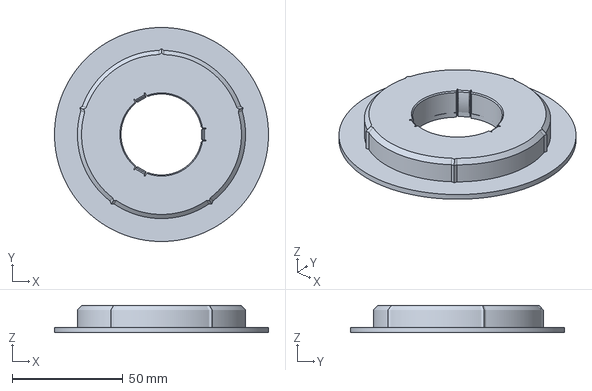
[picture p63: CAD file, 2026-10-28]
rings/stock-sizes/models/kraken-spool-ring-76-mm-pentagon-gear-side-2.2mm-flange.3mf
96.5 x 96.5 x 12.2 mm
