thereprocase/kraken-remix-ogAMS/rings/round-flanges/models-skinny/kraken-spool-ring-78-mm-round-gear-side-0.4mm-flange.stl

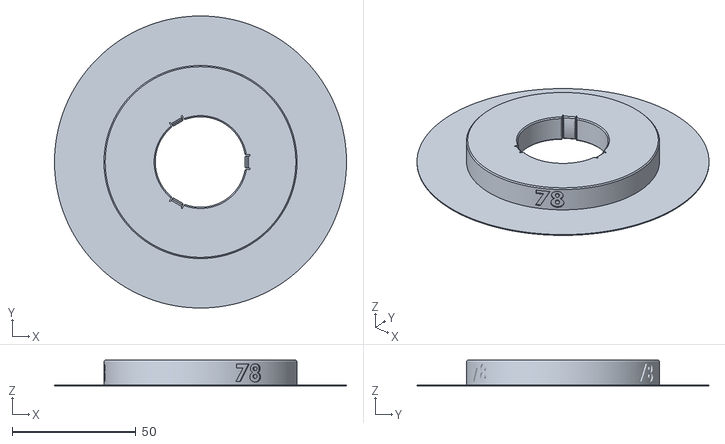
[picture p64: CAD file, 2026-10-28]
rings/round-flanges/models-skinny/kraken-spool-ring-78-mm-round-gear-side-0.4mm-flange.stl
118.0 x 118.0 x 10.4
