thereprocase/kraken-remix-ogAMS/rings/round-flanges/models/kraken-spool-ring-92-mm-round-gear-side-2.2mm-flange.stl

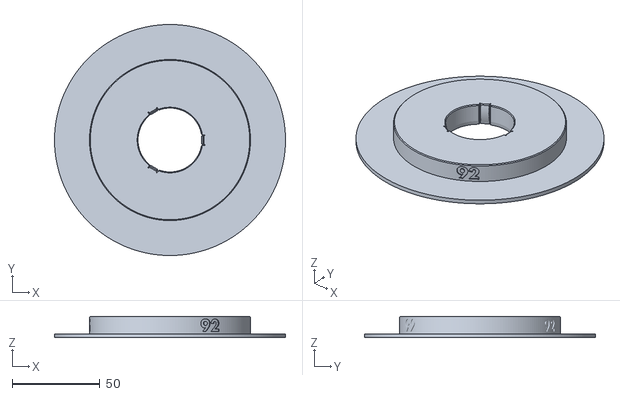
[picture p65: CAD file, 2026-10-28]
rings/round-flanges/models/kraken-spool-ring-92-mm-round-gear-side-2.2mm-flange.stl
132.0 x 132.0 x 12.2
