thereprocase/kraken-remix-ogAMS/rings/source/reference/kraken-spool-ring-73-mm-100.3mf

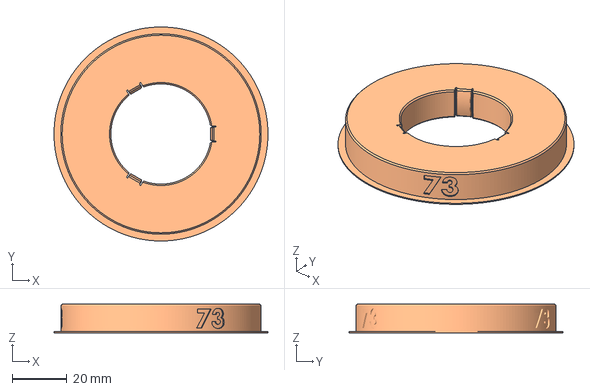
[picture p66: CAD file, 2026-10-16]
rings/source/reference/kraken-spool-ring-73-mm-100.3mf
78.0 x 78.0 x 10.4 mm
