thereprocase/kraken-remix-ogAMS/rings/round-flanges/models-skinny/kraken-spool-ring-84-mm-round-cap-side-0.4mm-lip.stl

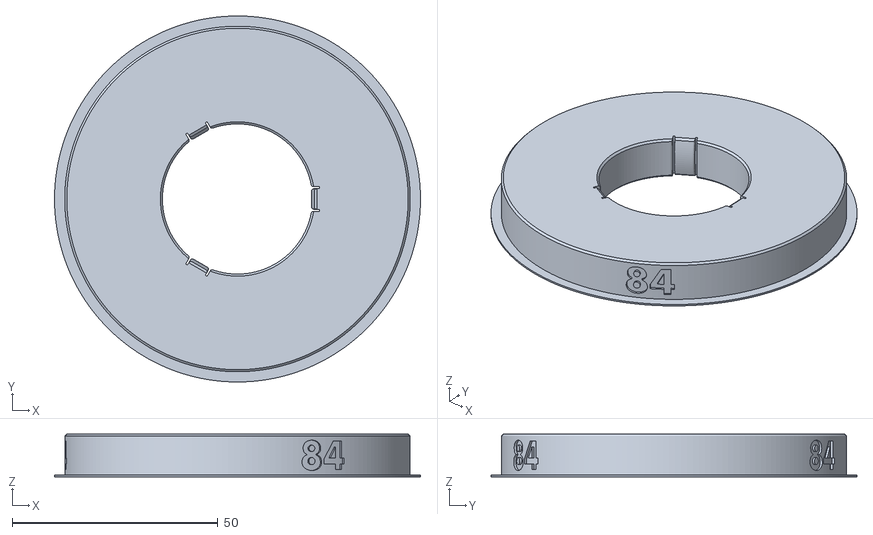
[picture p69: CAD file, 2026-10-28]
rings/round-flanges/models-skinny/kraken-spool-ring-84-mm-round-cap-side-0.4mm-lip.stl
89.0 x 89.0 x 10.4
