thereprocase/kraken-remix-ogAMS/rings/round-flanges/models/kraken-spool-ring-85-mm-round-cap-side-0.6mm-lip.stl

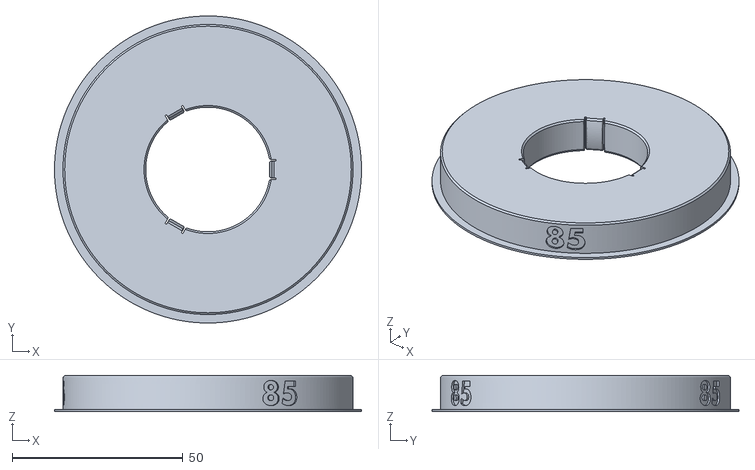
[picture p70: CAD file, 2026-10-28]
rings/round-flanges/models/kraken-spool-ring-85-mm-round-cap-side-0.6mm-lip.stl
90.0 x 90.0 x 10.6
