thereprocase/kraken-remix-ogAMS/rings/source/reference/kraken-spool-ring-88-mm-100.3mf

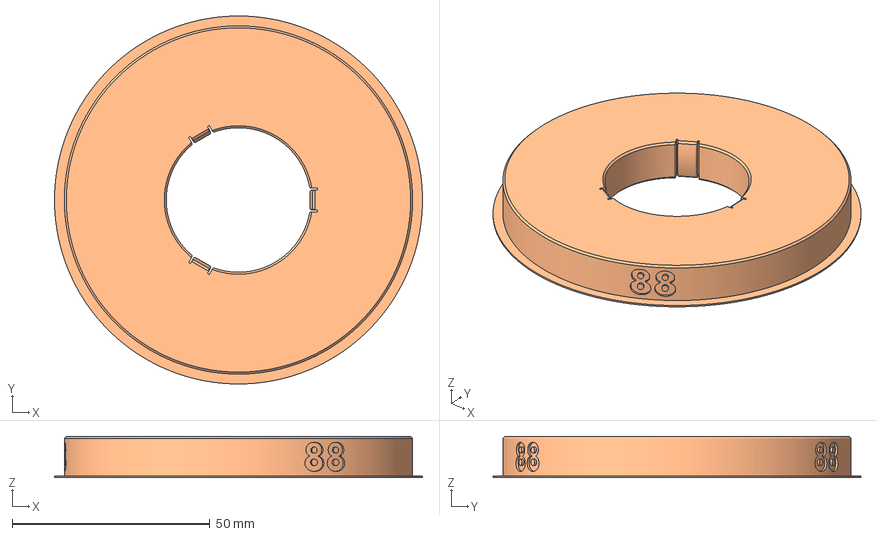
[picture p71: CAD file, 2026-10-16]
rings/source/reference/kraken-spool-ring-88-mm-100.3mf
93.0 x 93.0 x 10.4 mm
