thereprocase/kraken-remix-ogAMS/rings/stock-sizes/models-skinny/kraken-spool-ring-49-mm-pentagon-gear-side-0.4mm-flange.3mf

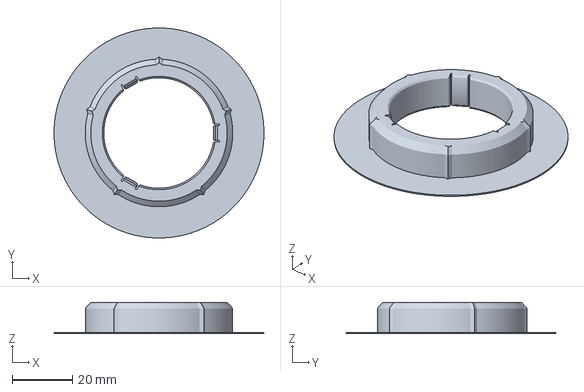
[picture p72: CAD file, 2026-10-28]
rings/stock-sizes/models-skinny/kraken-spool-ring-49-mm-pentagon-gear-side-0.4mm-flange.3mf
69.5 x 69.5 x 10.4 mm
