thereprocase/kraken-remix-ogAMS/rings/round-flanges/models-skinny/kraken-spool-ring-49-mm-round-cap-side-0.4mm-lip.stl

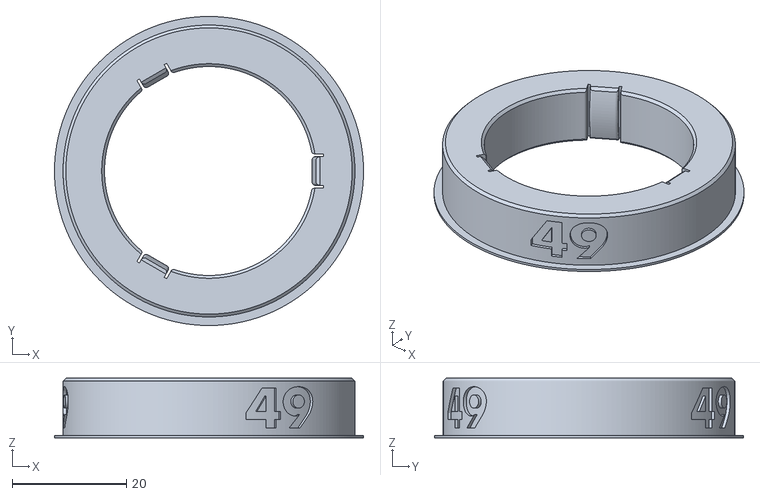
[picture p74: CAD file, 2026-10-28]
rings/round-flanges/models-skinny/kraken-spool-ring-49-mm-round-cap-side-0.4mm-lip.stl
54.0 x 54.0 x 10.4
