thereprocase/kraken-remix-ogAMS/rings/round-flanges/models/kraken-spool-ring-58-mm-round-cap-side-0.6mm-lip.stl

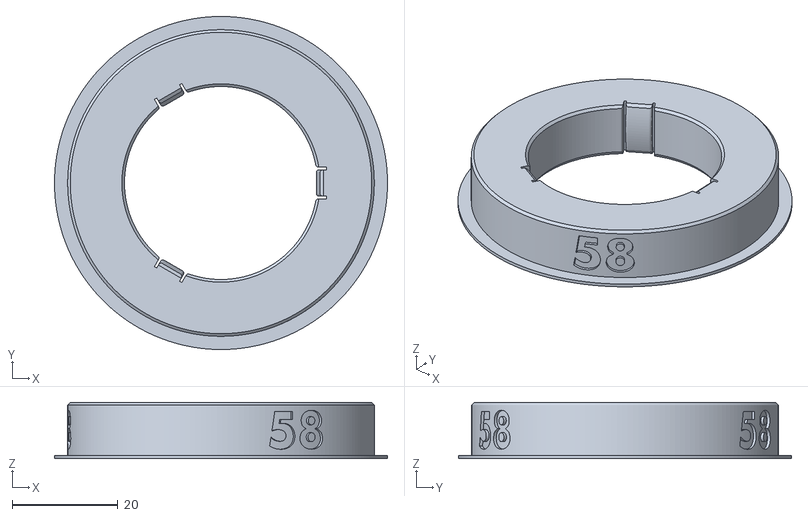
[picture p75: CAD file, 2026-10-28]
rings/round-flanges/models/kraken-spool-ring-58-mm-round-cap-side-0.6mm-lip.stl
63.0 x 63.0 x 10.6
