thereprocase/kraken-remix-ogAMS/rings/source/reference/kraken-spool-ring-89-mm-100.3mf

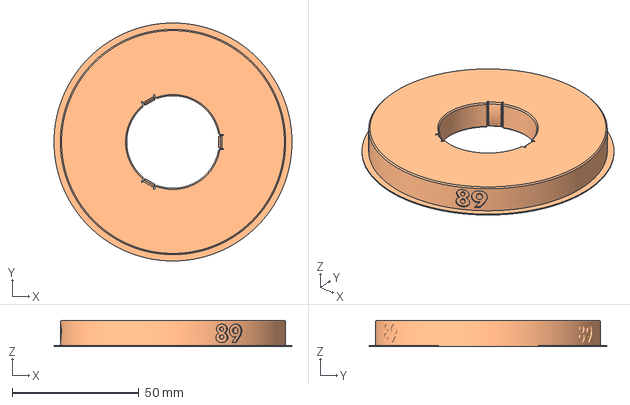
[picture p76: CAD file, 2026-10-16]
rings/source/reference/kraken-spool-ring-89-mm-100.3mf
94.0 x 94.0 x 10.4 mm
