thereprocase/kraken-remix-ogAMS/rings/round-flanges/models-skinny/kraken-spool-ring-77-mm-round-cap-side-0.4mm-lip.stl

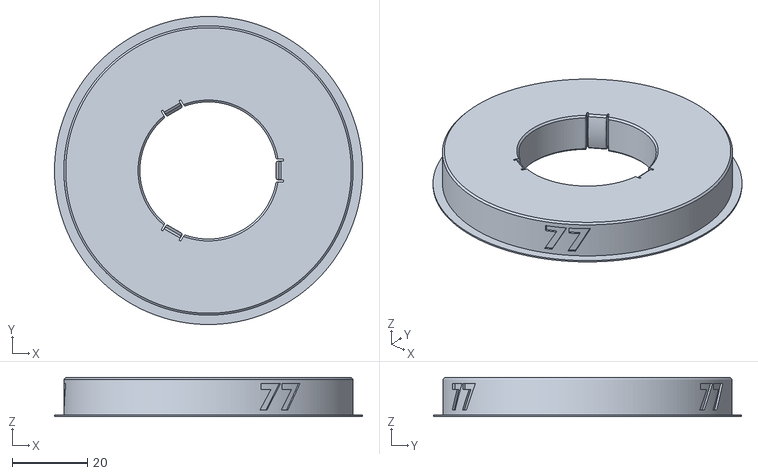
[picture p78: CAD file, 2026-10-28]
rings/round-flanges/models-skinny/kraken-spool-ring-77-mm-round-cap-side-0.4mm-lip.stl
82.0 x 82.0 x 10.4
