thereprocase/kraken-remix-ogAMS/rings/round-flanges/models/kraken-spool-ring-91-mm-round-gear-side-2.2mm-flange.stl

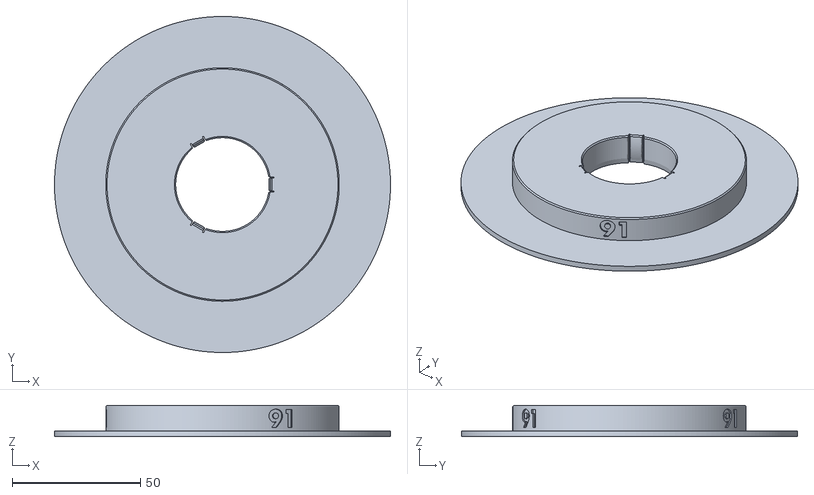
[picture p79: CAD file, 2026-10-28]
rings/round-flanges/models/kraken-spool-ring-91-mm-round-gear-side-2.2mm-flange.stl
131.0 x 131.0 x 12.2
