thereprocase/kraken-remix-ogAMS/rings/source/reference/kraken-spool-ring-69-mm-100.3mf

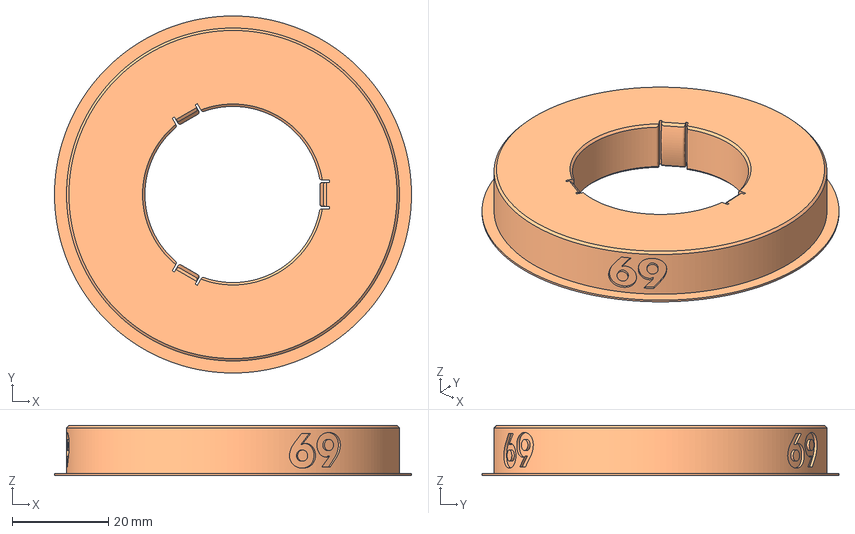
[picture p80: CAD file, 2026-10-16]
rings/source/reference/kraken-spool-ring-69-mm-100.3mf
74.0 x 74.0 x 10.4 mm
