thereprocase/kraken-remix-ogAMS/rings/stock-sizes/models/kraken-spool-ring-95-mm-pentagon-gear-side-2.2mm-flange.3mf

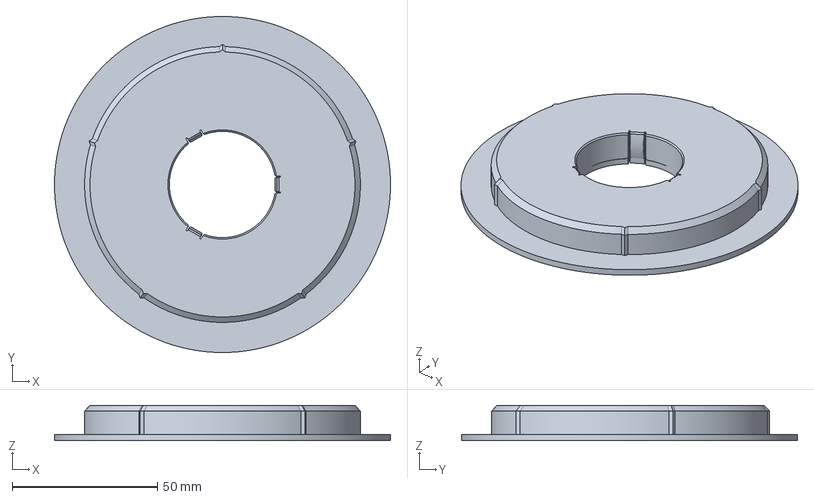
[picture p82: CAD file, 2026-10-28]
rings/stock-sizes/models/kraken-spool-ring-95-mm-pentagon-gear-side-2.2mm-flange.3mf
115.5 x 115.5 x 12.2 mm
