thereprocase/kraken-remix-ogAMS/rings/round-flanges/models-skinny/kraken-spool-ring-60-mm-round-cap-side-0.4mm-lip.stl

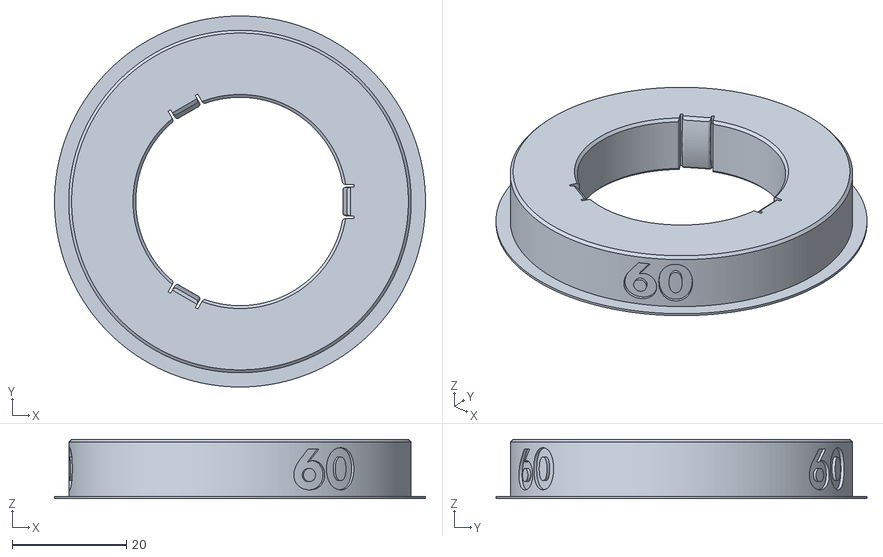
[picture p83: CAD file, 2026-10-28]
rings/round-flanges/models-skinny/kraken-spool-ring-60-mm-round-cap-side-0.4mm-lip.stl
65.0 x 65.0 x 10.4
