thereprocase/kraken-remix-ogAMS/rings/source/reference/kraken-spool-ring-79-mm-100.3mf

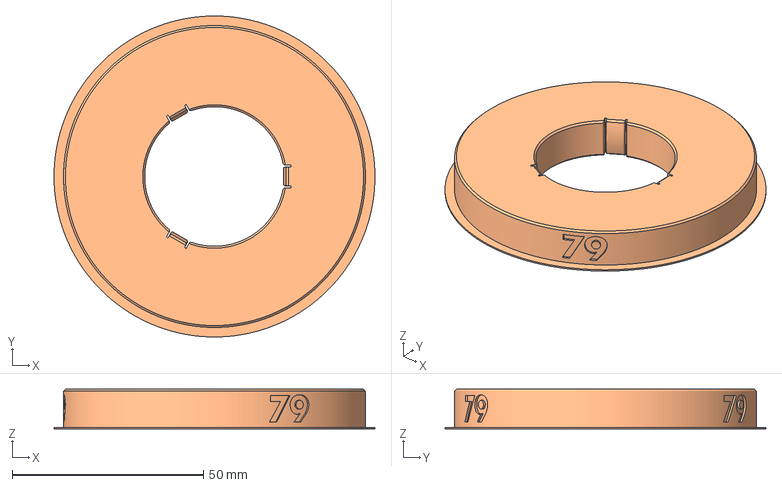
[picture p84: CAD file, 2026-10-16]
rings/source/reference/kraken-spool-ring-79-mm-100.3mf
84.0 x 84.0 x 10.4 mm
