thereprocase/kraken-remix-ogAMS/rings/stock-sizes/models/kraken-spool-ring-73-mm-pentagon-gear-side-2.2mm-flange.3mf

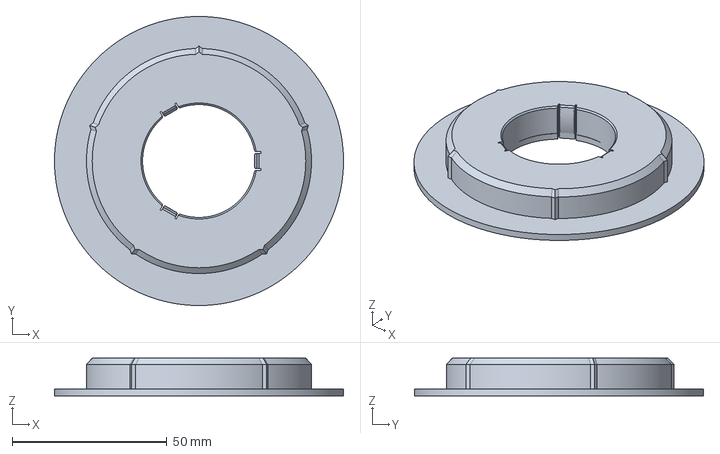
[picture p85: CAD file, 2026-10-28]
rings/stock-sizes/models/kraken-spool-ring-73-mm-pentagon-gear-side-2.2mm-flange.3mf
93.5 x 93.5 x 12.2 mm
