thereprocase/kraken-remix-ogAMS/rings/round-flanges/models/kraken-spool-ring-61-mm-round-gear-side-2.2mm-flange.stl

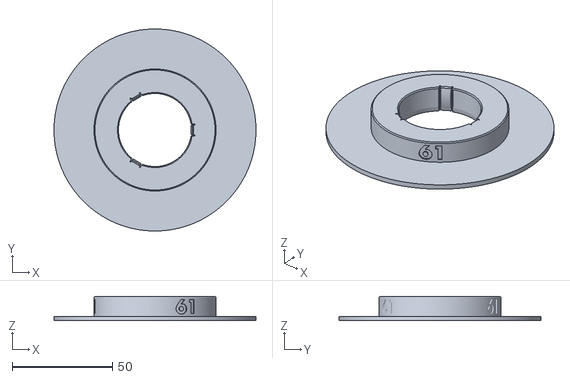
[picture p86: CAD file, 2026-10-28]
rings/round-flanges/models/kraken-spool-ring-61-mm-round-gear-side-2.2mm-flange.stl
101.0 x 101.0 x 12.2
