thereprocase/kraken-remix-ogAMS/rings/source/reference/kraken-spool-ring-54-mm-100.3mf

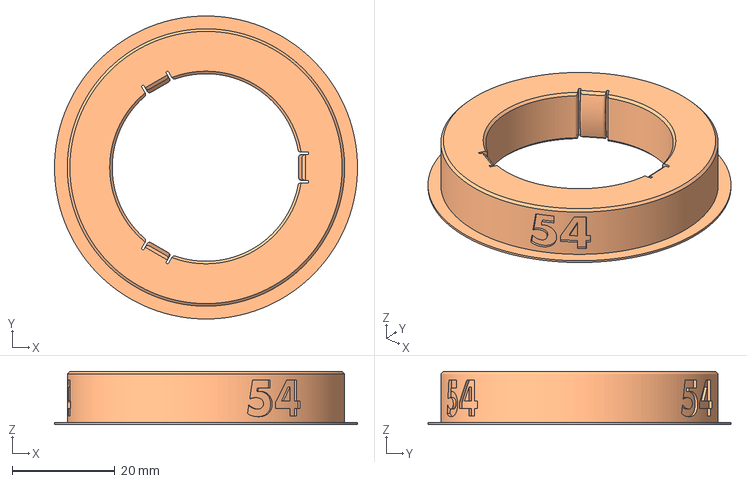
[picture p87: CAD file, 2026-10-16]
rings/source/reference/kraken-spool-ring-54-mm-100.3mf
59.0 x 59.0 x 10.4 mm
