thereprocase/kraken-remix-ogAMS/rings/round-flanges/models-skinny/kraken-spool-ring-73-mm-round-gear-side-0.4mm-flange.stl

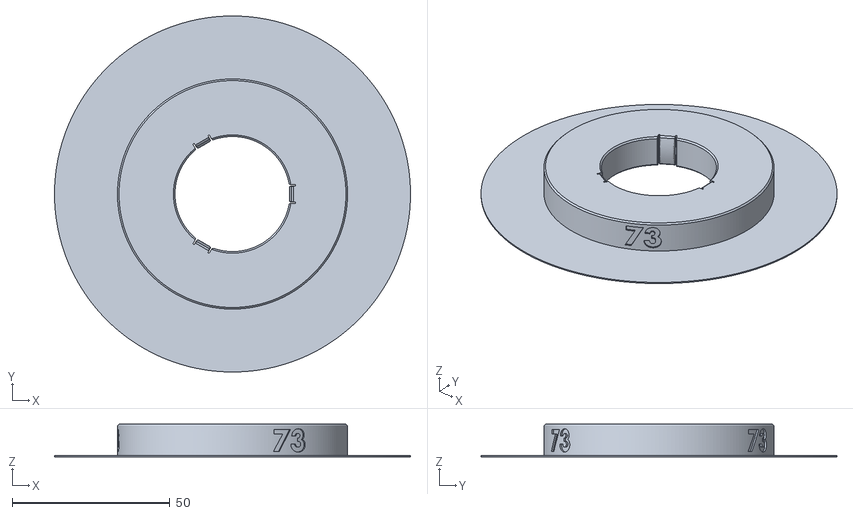
[picture p89: CAD file, 2026-10-28]
rings/round-flanges/models-skinny/kraken-spool-ring-73-mm-round-gear-side-0.4mm-flange.stl
113.0 x 113.0 x 10.4
