thereprocase/kraken-remix-ogAMS/rings/round-flanges/models/kraken-spool-ring-54-mm-round-cap-side-0.6mm-lip.stl

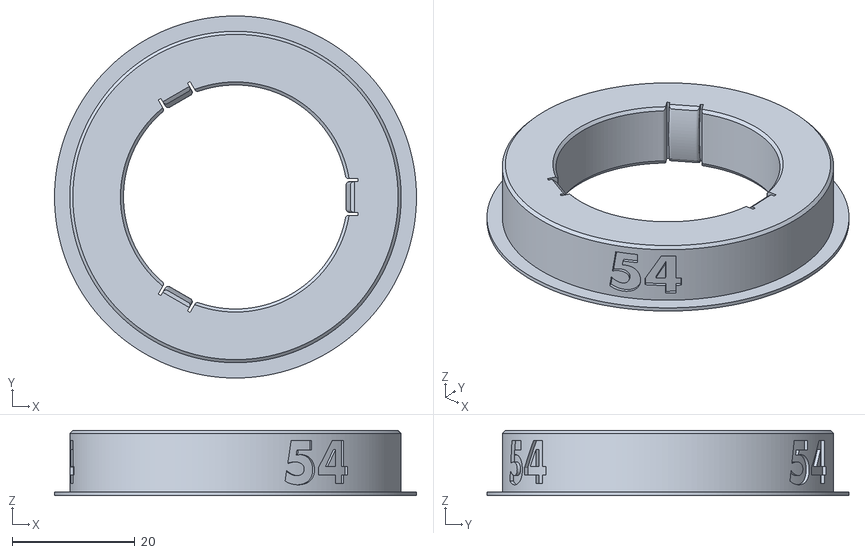
[picture p90: CAD file, 2026-10-28]
rings/round-flanges/models/kraken-spool-ring-54-mm-round-cap-side-0.6mm-lip.stl
59.0 x 59.0 x 10.6
