thereprocase/kraken-remix-ogAMS/rings/source/reference/kraken-spool-ring-85-mm-100.3mf

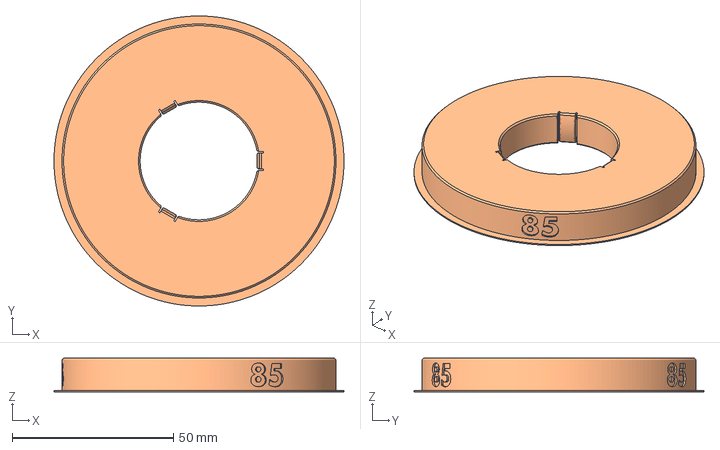
[picture p91: CAD file, 2026-10-16]
rings/source/reference/kraken-spool-ring-85-mm-100.3mf
90.0 x 90.0 x 10.4 mm
