thereprocase/kraken-remix-ogAMS/rings/round-flanges/models-skinny/kraken-spool-ring-75-mm-round-cap-side-0.4mm-lip.stl

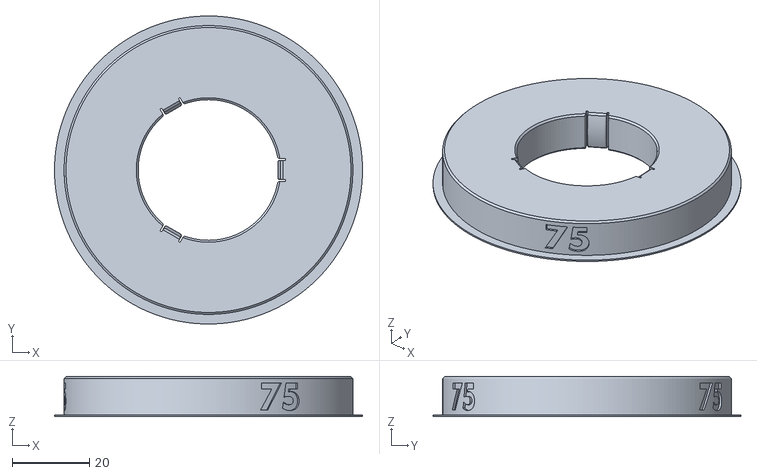
[picture p93: CAD file, 2026-10-28]
rings/round-flanges/models-skinny/kraken-spool-ring-75-mm-round-cap-side-0.4mm-lip.stl
80.0 x 80.0 x 10.4
