thereprocase/kraken-remix-ogAMS/rings/round-flanges/models/kraken-spool-ring-81-mm-round-gear-side-2.2mm-flange.stl

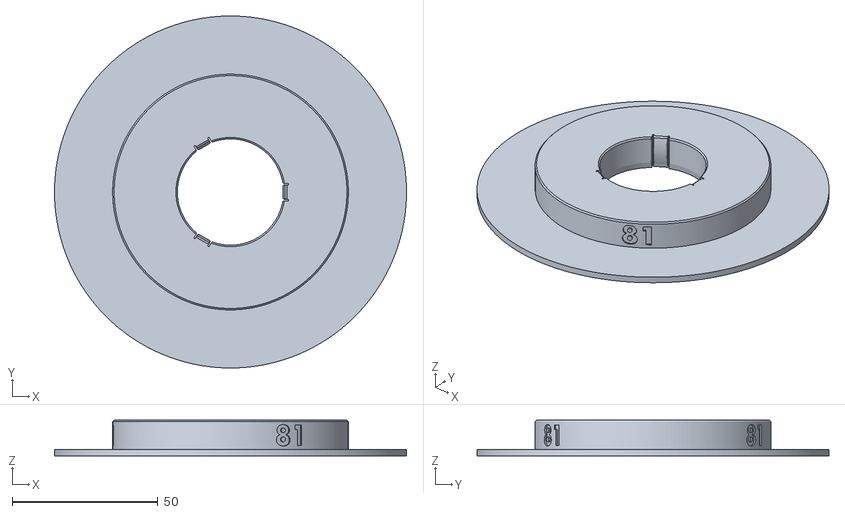
[picture p94: CAD file, 2026-10-28]
rings/round-flanges/models/kraken-spool-ring-81-mm-round-gear-side-2.2mm-flange.stl
121.0 x 121.0 x 12.2
