thereprocase/kraken-remix-ogAMS/rings/source/reference/kraken-spool-ring-74-mm-100.3mf

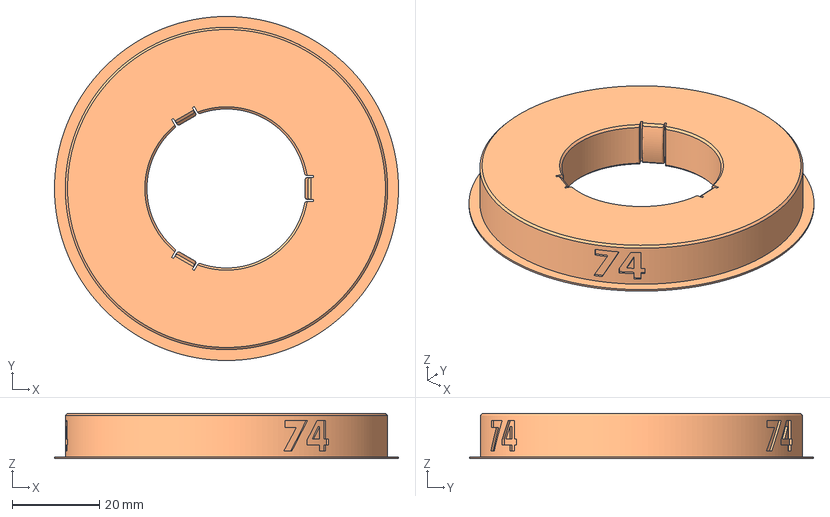
[picture p95: CAD file, 2026-10-16]
rings/source/reference/kraken-spool-ring-74-mm-100.3mf
79.0 x 79.0 x 10.4 mm
