thereprocase/kraken-remix-ogAMS/rings/source/reference/kraken-spool-ring-65-mm-100.3mf

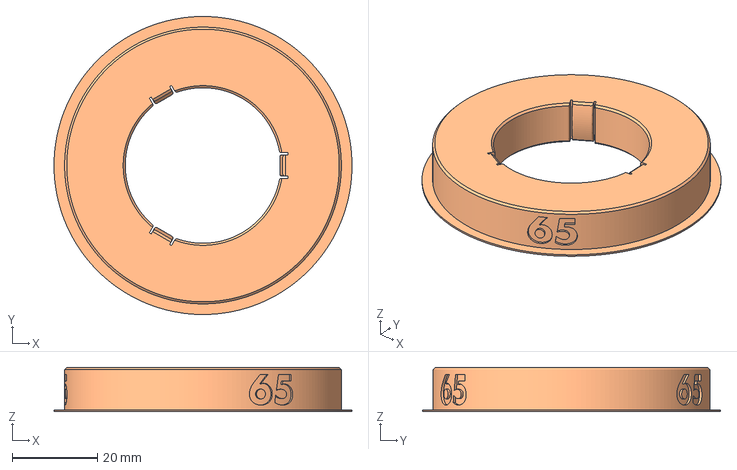
[picture p98: CAD file, 2026-10-16]
rings/source/reference/kraken-spool-ring-65-mm-100.3mf
70.0 x 70.0 x 10.4 mm
