thereprocase/kraken-remix-ogAMS/rings/stock-sizes/models/kraken-spool-ring-77-mm-pentagon-cap-side-0.6mm-lip.3mf

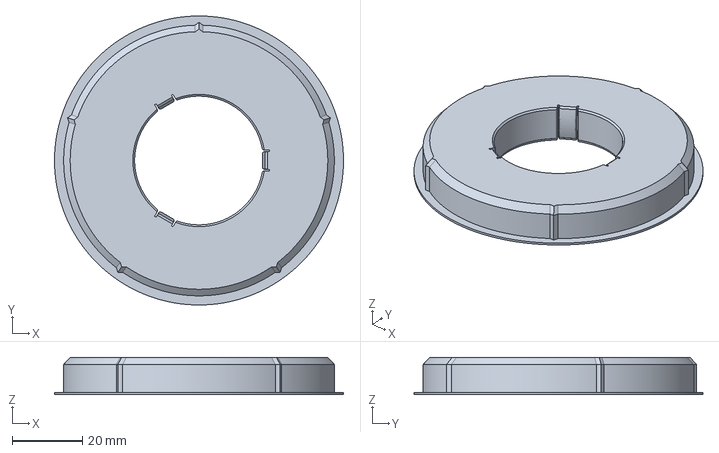
[picture p99: CAD file, 2026-10-28]
rings/stock-sizes/models/kraken-spool-ring-77-mm-pentagon-cap-side-0.6mm-lip.3mf
82.0 x 82.0 x 10.6 mm
