thereprocase/kraken-remix-ogAMS/rings/round-flanges/models-skinny/kraken-spool-ring-65-mm-round-gear-side-0.4mm-flange.stl

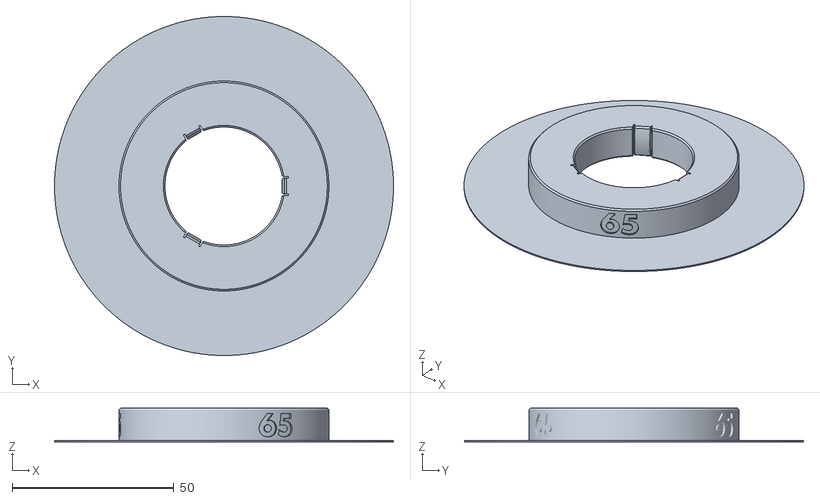
[picture p100: CAD file, 2026-10-28]
rings/round-flanges/models-skinny/kraken-spool-ring-65-mm-round-gear-side-0.4mm-flange.stl
105.0 x 105.0 x 10.4
