thereprocase/kraken-remix-ogAMS/rings/round-flanges/models/kraken-spool-ring-75-mm-round-gear-side-2.2mm-flange.stl

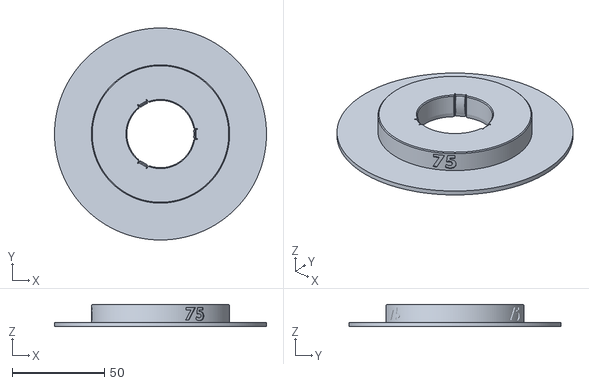
[picture p101: CAD file, 2026-10-28]
rings/round-flanges/models/kraken-spool-ring-75-mm-round-gear-side-2.2mm-flange.stl
115.0 x 115.0 x 12.2
