thereprocase/kraken-remix-ogAMS/rings/source/reference/kraken-spool-ring-91-mm-100.3mf

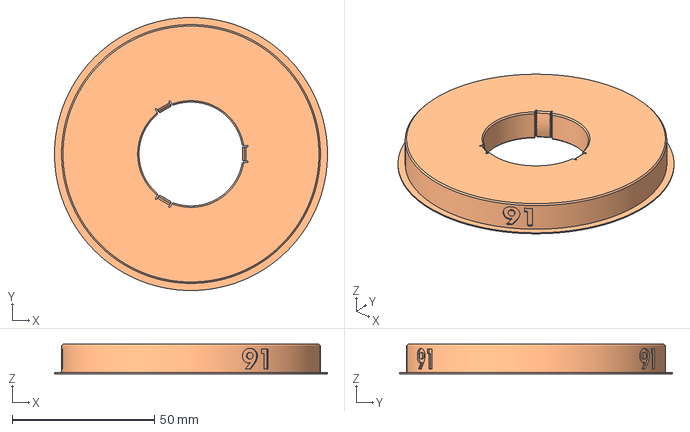
[picture p102: CAD file, 2026-10-16]
rings/source/reference/kraken-spool-ring-91-mm-100.3mf
96.0 x 96.0 x 10.4 mm
