thereprocase/kraken-remix-ogAMS/rings/stock-sizes/models/kraken-spool-ring-65-mm-pentagon-gear-side-2.2mm-flange.3mf

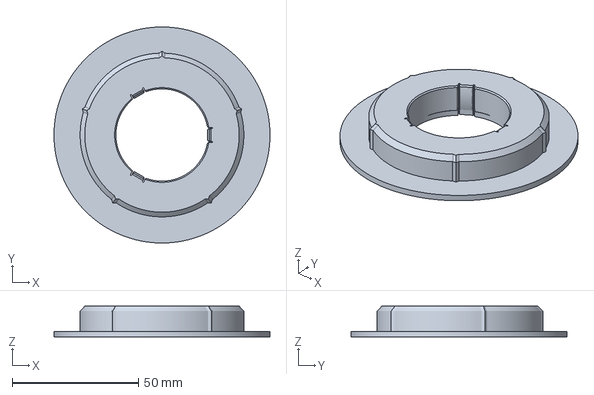
[picture p103: CAD file, 2026-10-28]
rings/stock-sizes/models/kraken-spool-ring-65-mm-pentagon-gear-side-2.2mm-flange.3mf
85.5 x 85.5 x 12.2 mm
