thereprocase/kraken-remix-ogAMS/rings/round-flanges/models/kraken-spool-ring-57-mm-round-gear-side-2.2mm-flange.stl

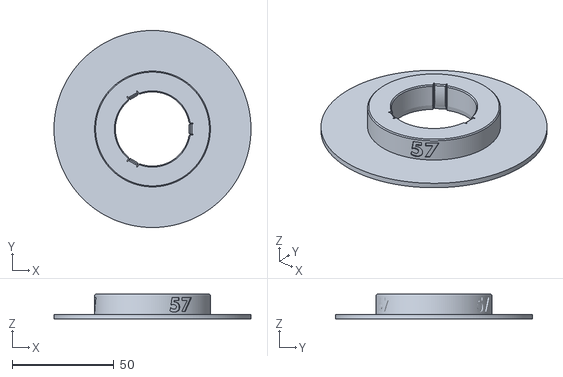
[picture p104: CAD file, 2026-10-28]
rings/round-flanges/models/kraken-spool-ring-57-mm-round-gear-side-2.2mm-flange.stl
97.0 x 97.0 x 12.2
