thereprocase/kraken-remix-ogAMS/rings/source/reference/kraken-spool-ring-55-mm-100.3mf

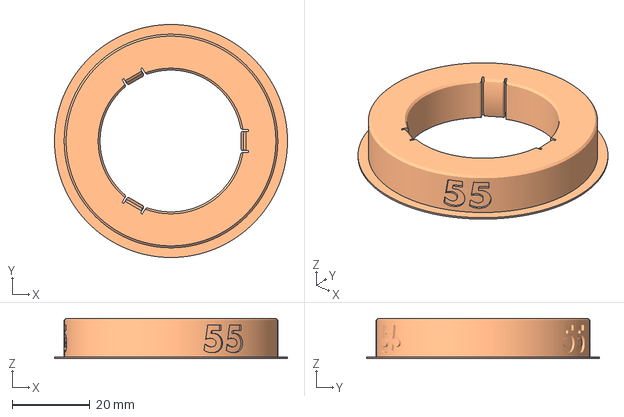
[picture p105: CAD file, 2026-10-16]
rings/source/reference/kraken-spool-ring-55-mm-100.3mf
60.0 x 60.0 x 10.4 mm
