thereprocase/kraken-remix-ogAMS/rings/stock-sizes/models-skinny/kraken-spool-ring-85-mm-pentagon-gear-side-0.4mm-flange.3mf

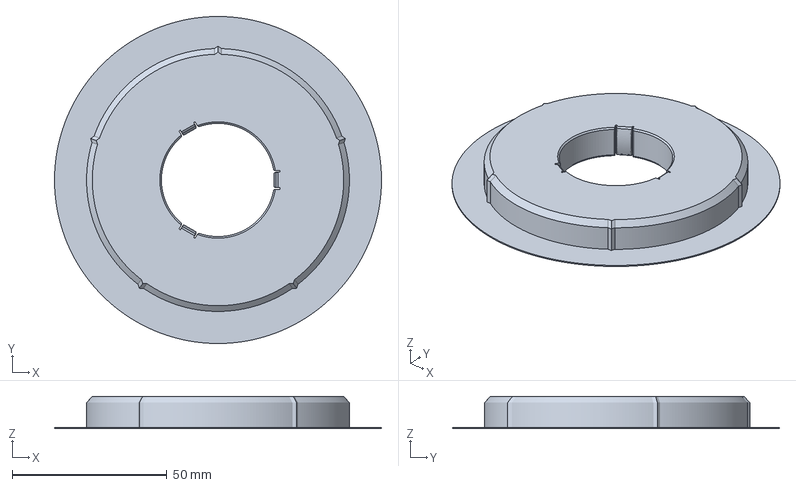
[picture p106: CAD file, 2026-10-28]
rings/stock-sizes/models-skinny/kraken-spool-ring-85-mm-pentagon-gear-side-0.4mm-flange.3mf
105.5 x 105.5 x 10.4 mm
