thereprocase/kraken-remix-ogAMS/rings/stock-sizes/models/kraken-spool-ring-85-mm-pentagon-gear-side-2.2mm-flange.3mf

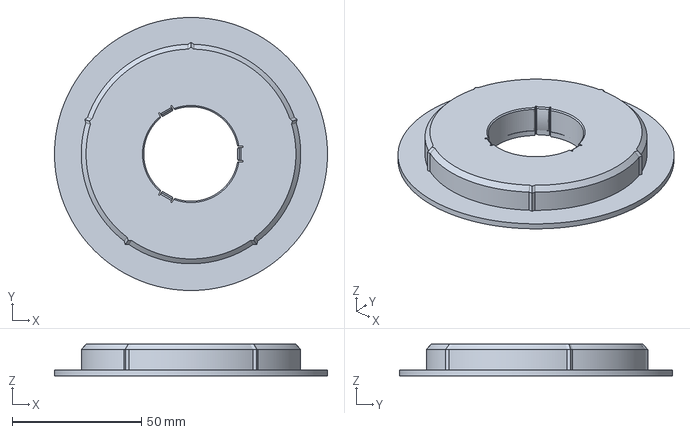
[picture p107: CAD file, 2026-10-28]
rings/stock-sizes/models/kraken-spool-ring-85-mm-pentagon-gear-side-2.2mm-flange.3mf
105.5 x 105.5 x 12.2 mm
