thereprocase/kraken-remix-ogAMS/rings/round-flanges/models/kraken-spool-ring-73-mm-round-gear-side-2.2mm-flange.stl

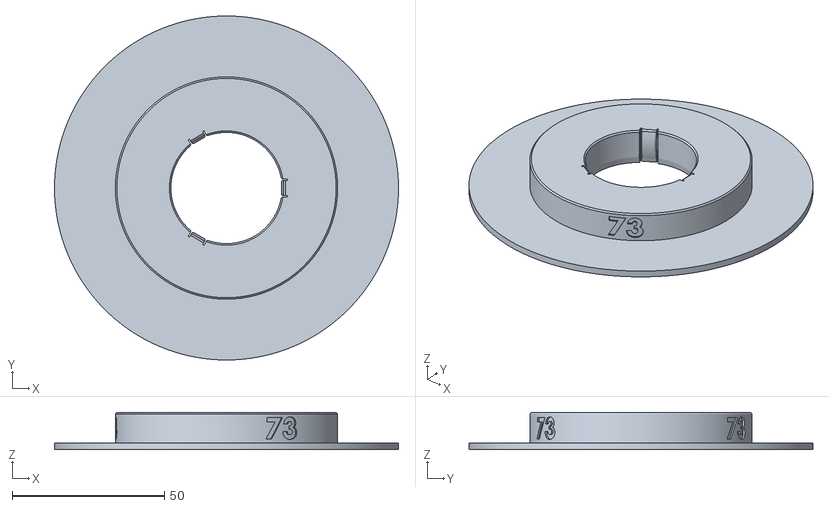
[picture p108: CAD file, 2026-10-28]
rings/round-flanges/models/kraken-spool-ring-73-mm-round-gear-side-2.2mm-flange.stl
113.0 x 113.0 x 12.2
