thereprocase/kraken-remix-ogAMS/rings/source/reference/kraken-spool-ring-47-mm-100.3mf

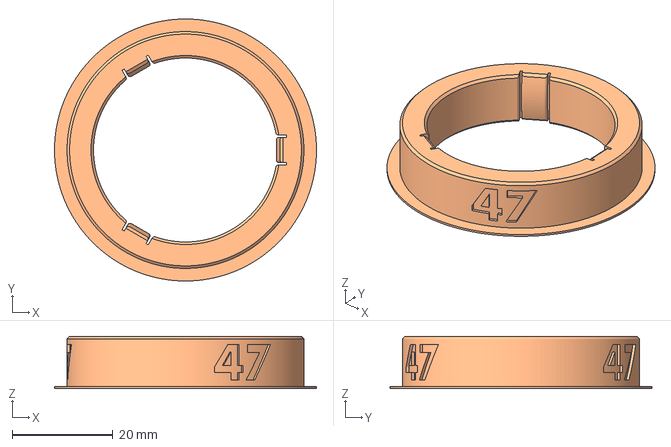
[picture p109: CAD file, 2026-10-16]
rings/source/reference/kraken-spool-ring-47-mm-100.3mf
52.0 x 52.0 x 10.4 mm
