thereprocase/kraken-remix-ogAMS/rings/round-flanges/models/kraken-spool-ring-68-mm-round-cap-side-0.6mm-lip.stl

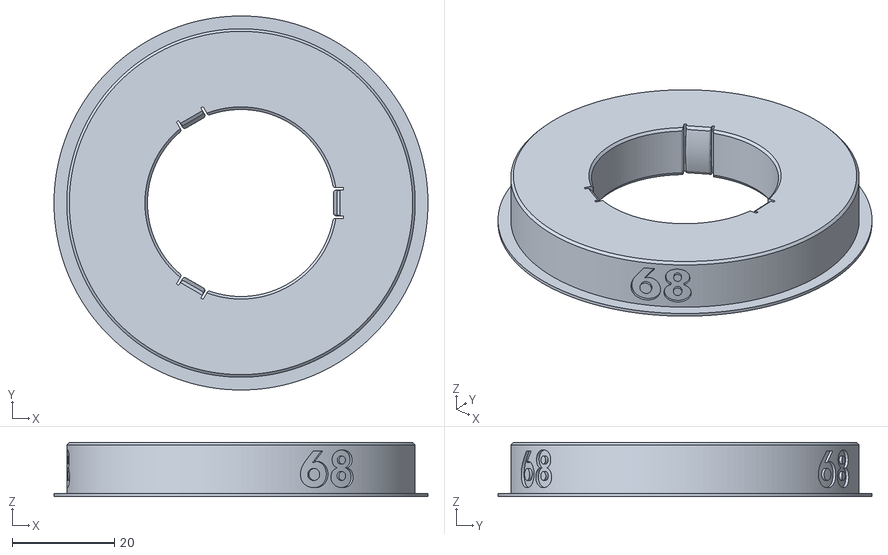
[picture p112: CAD file, 2026-10-28]
rings/round-flanges/models/kraken-spool-ring-68-mm-round-cap-side-0.6mm-lip.stl
73.0 x 73.0 x 10.6
