thereprocase/kraken-remix-ogAMS/rings/source/reference/kraken-spool-ring-86-mm-100.3mf

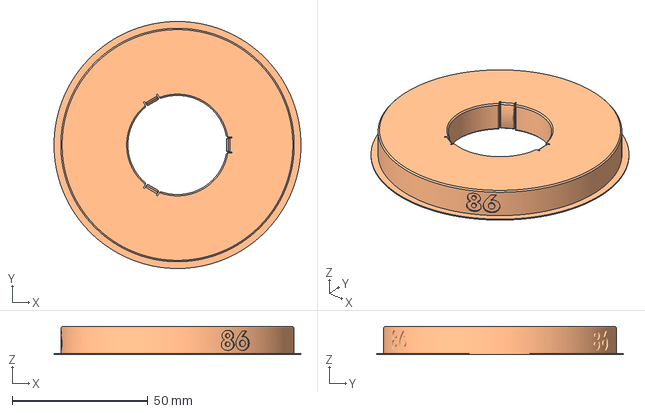
[picture p113: CAD file, 2026-10-16]
rings/source/reference/kraken-spool-ring-86-mm-100.3mf
91.0 x 91.0 x 10.4 mm
