thereprocase/kraken-remix-ogAMS/rings/round-flanges/models/kraken-spool-ring-87-mm-round-cap-side-0.6mm-lip.stl

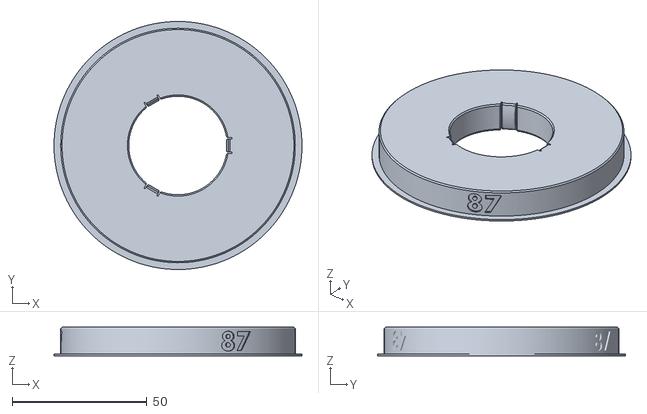
[picture p115: CAD file, 2026-10-28]
rings/round-flanges/models/kraken-spool-ring-87-mm-round-cap-side-0.6mm-lip.stl
92.0 x 92.0 x 10.6
