thereprocase/kraken-remix-ogAMS/rings/source/reference/kraken-spool-ring-56-mm-100.3mf

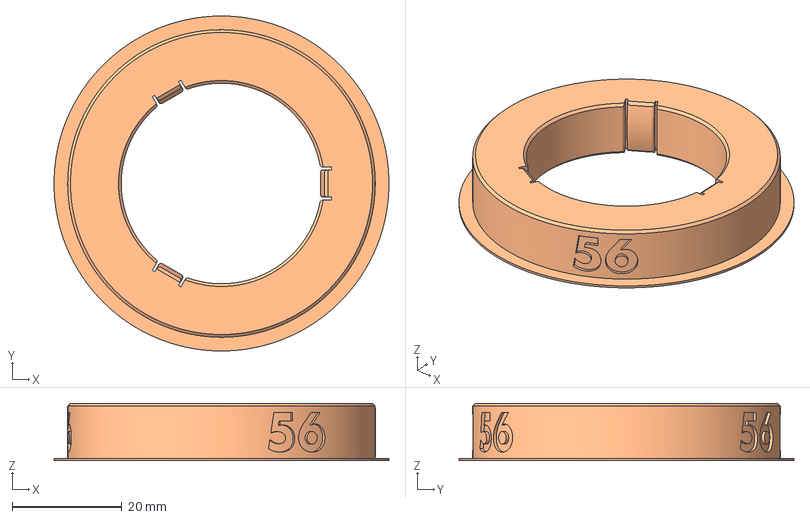
[picture p116: CAD file, 2026-10-16]
rings/source/reference/kraken-spool-ring-56-mm-100.3mf
61.0 x 61.0 x 10.4 mm
