thereprocase/kraken-remix-ogAMS/(list of files, cad)

Other CAD files:
models/left-body-pocket_full.step
models/right-body-pocket_full.step
prints/pctg-2026-10-28-v5/right-front-bar-v5-assembly.step
gear/source/reference/original-gear.stl
prints/asa-2026-10-16/right-body-v4-model.3mf
prints/pctg-2026-10-28-v5/right-body-v5.step
models/left-front-bar-standard_cut5.step
prints/pctg-2026-10-28-v5/left-body-v5.step
reloadable-spool/artifacts/backing-sleeve.step
reloadable-spool/revisions/uniform-flange-6mm/artifacts/backing-sleeve-keyless.step
rings/hard-spool/models-skinny/kraken-spool-ring-52.1-mm-spring-gear-side-0.4mm-flange.3mf
coupons/cut5_fit/artifacts/socket_3_c020.step
prints/pctg-2026-10-28-v5/right-body-v5-model.3mf
coupons/cut5_fit/artifacts/socket_1_c010.step
models/right-front-bar-standard_cut5.step
prints/pctg-2026-10-28-v5/left-body-v5-model.3mf
rings/round-flanges/models/kraken-spool-ring-70-mm-round-gear-side-2.2mm-flange.stl
models/left-body-standard_cut5.step
prints/pctg-2026-10-28-v5/right-front-bar-v5.step
prints/pctg-2026-10-28-v5/left-front-bar-v5.step
prints/pctg-2026-10-28-v5/left-front-bar-v5-model.3mf
rings/stock-sizes/models-skinny/kraken-spool-ring-56-mm-pentagon-gear-side-0.4mm-flange.3mf
models/left-body-pocket_cut5.step
prints/pctg-2026-10-28-v5/right-front-bar-v5-model.3mf
models/right-front-bar-pocket_cut5.step
rings/round-flanges/models/kraken-spool-ring-82-mm-round-gear-side-2.2mm-flange.stl
rings/stock-sizes/models-skinny/kraken-spool-ring-67-mm-pentagon-gear-side-0.4mm-flange.3mf
models/right-body-pocket_cut5.step
rings/round-flanges/models-skinny/kraken-spool-ring-67-mm-round-gear-side-0.4mm-flange.stl
rings/stock-sizes/models/kraken-spool-ring-53-mm-pentagon-gear-side-2.2mm-flange.3mf
models/left-front-bar-pocket_cut5.step
rings/stock-sizes/models-skinny/kraken-spool-ring-66-mm-pentagon-gear-side-0.4mm-flange.3mf
rings/round-flanges/models-skinny/kraken-spool-ring-81-mm-round-cap-side-0.4mm-lip.stl
rings/round-flanges/models/kraken-spool-ring-54-mm-round-gear-side-2.2mm-flange.stl
rings/stock-sizes/models-skinny/kraken-spool-ring-82-mm-pentagon-gear-side-0.4mm-flange.3mf
rings/stock-sizes/models-skinny/kraken-spool-ring-80-mm-pentagon-gear-side-0.4mm-flange.3mf
rings/round-flanges/models-skinny/kraken-spool-ring-79-mm-round-gear-side-0.4mm-flange.stl
rings/round-flanges/models-skinny/kraken-spool-ring-68-mm-round-gear-side-0.4mm-flange.stl
rings/round-flanges/models-skinny/kraken-spool-ring-79-mm-round-cap-side-0.4mm-lip.stl
rings/stock-sizes/models-skinny/kraken-spool-ring-64-mm-pentagon-gear-side-0.4mm-flange.3mf
rings/round-flanges/models-skinny/kraken-spool-ring-50-mm-round-gear-side-0.4mm-flange.stl
rings/stock-sizes/models-skinny/kraken-spool-ring-93-mm-pentagon-gear-side-0.4mm-flange.3mf
coupons/cut5_alignment84/artifacts/left_keys_84_nominal.3mf
coupons/cut5_alignment84/artifacts/left_sockets_84_nominal.3mf
coupons/cut5_alignment84/artifacts/right_keys_84_nominal.3mf
coupons/cut5_alignment84/artifacts/right_sockets_84_nominal.3mf
coupons/cut5_fit/artifacts/key_common.3mf
coupons/cut5_fit/artifacts/socket_1_c010.3mf
coupons/cut5_fit/artifacts/socket_2_c015_nominal.3mf
coupons/cut5_fit/artifacts/socket_3_c020.3mf
gear/models/gear-spokes.stl
models/left-body-pocket_cut5.3mf
models/left-body-pocket_full.3mf
models/left-body-standard_cut5.3mf
models/left-body-standard_full.3mf
models/left-front-bar-pocket_cut5.3mf
models/left-front-bar-standard_cut5.3mf
models/right-body-pocket_cut5.3mf
models/right-body-pocket_full.3mf
models/right-body-standard_cut5.3mf
models/right-body-standard_full.3mf
models/right-front-bar-pocket_cut5.3mf
models/right-front-bar-standard_cut5.3mf
reloadable-spool/artifacts/assembly-reference-NOT-FOR-PRINT.stl
reloadable-spool/artifacts/backing-sleeve.3mf
reloadable-spool/artifacts/backing-sleeve.stl
reloadable-spool/artifacts/removable-flange.3mf
reloadable-spool/artifacts/removable-flange.stl
reloadable-spool/reference/nut.stl
reloadable-spool/revisions/keyless-stiff-annulus/artifacts/backing-sleeve-keyless-installed.step
reloadable-spool/revisions/keyless-stiff-annulus/artifacts/backing-sleeve-keyless.3mf
reloadable-spool/revisions/keyless-stiff-annulus/artifacts/backing-sleeve-keyless.step
reloadable-spool/revisions/keyless-stiff-annulus/artifacts/removable-flange-stiff-annulus-installed.step
reloadable-spool/revisions/keyless-stiff-annulus/artifacts/removable-flange-stiff-annulus.3mf
reloadable-spool/revisions/keyless-stiff-annulus/artifacts/removable-flange-stiff-annulus.step
reloadable-spool/revisions/keyless-stiff-annulus/artifacts/removable-flange-stiff-annulus.stl
reloadable-spool/revisions/uniform-flange-6mm/artifacts/backing-sleeve-keyless.3mf
reloadable-spool/revisions/uniform-flange-6mm/artifacts/backing-sleeve-keyless.stl
reloadable-spool/revisions/uniform-flange-6mm/artifacts/removable-flange-stiff-annulus.3mf
reloadable-spool/revisions/uniform-flange-6mm/artifacts/removable-flange-stiff-annulus.stl
rings/brand-sizes/models-skinny/kraken-spool-ring-53.4-mm-pentagon-cap-side-0.4mm-lip.stl
rings/brand-sizes/models-skinny/kraken-spool-ring-53.4-mm-pentagon-gear-side-0.4mm-flange.stl
rings/brand-sizes/models/kraken-spool-ring-53.4-mm-pentagon-cap-side-0.6mm-lip.stl
rings/brand-sizes/models/kraken-spool-ring-53.4-mm-pentagon-gear-side-2.2mm-flange.stl
rings/hard-spool/models-skinny/kraken-spool-ring-52.1-mm-spring-cap-side-0.4mm-lip.stl
rings/hard-spool/models-skinny/kraken-spool-ring-52.1-mm-spring-gear-side-0.4mm-flange.stl
rings/hard-spool/models/kraken-spool-ring-52.1-mm-spring-cap-side-0.6mm-lip.stl
rings/hard-spool/models/kraken-spool-ring-52.1-mm-spring-gear-side-2.2mm-flange.stl
rings/models-skinny/kraken-spool-ring-55.5-mm-pentagon-cap-side-0.4mm-lip.stl
rings/models-skinny/kraken-spool-ring-55.5-mm-pentagon-gear-side-0.4mm-flange.stl
rings/models/kraken-spool-ring-55.5-mm-pentagon-cap-side-0.6mm-lip.stl
rings/models/kraken-spool-ring-55.5-mm-pentagon-gear-side-2.2mm-flange.stl
rings/round-flanges/models-skinny/kraken-spool-ring-45-mm-round-cap-side-0.4mm-lip.stl
rings/round-flanges/models-skinny/kraken-spool-ring-45-mm-round-gear-side-0.4mm-flange.stl
rings/round-flanges/models-skinny/kraken-spool-ring-46-mm-round-cap-side-0.4mm-lip.stl
rings/round-flanges/models-skinny/kraken-spool-ring-47-mm-round-cap-side-0.4mm-lip.stl
rings/round-flanges/models-skinny/kraken-spool-ring-47-mm-round-gear-side-0.4mm-flange.stl
rings/round-flanges/models-skinny/kraken-spool-ring-48-mm-round-cap-side-0.4mm-lip.stl
rings/round-flanges/models-skinny/kraken-spool-ring-48-mm-round-gear-side-0.4mm-flange.stl
rings/round-flanges/models-skinny/kraken-spool-ring-49-mm-round-gear-side-0.4mm-flange.stl
rings/round-flanges/models-skinny/kraken-spool-ring-50-mm-round-cap-side-0.4mm-lip.stl
rings/round-flanges/models-skinny/kraken-spool-ring-51-mm-round-cap-side-0.4mm-lip.stl
rings/round-flanges/models-skinny/kraken-spool-ring-51-mm-round-gear-side-0.4mm-flange.stl
rings/round-flanges/models-skinny/kraken-spool-ring-52-mm-round-cap-side-0.4mm-lip.stl
rings/round-flanges/models-skinny/kraken-spool-ring-52-mm-round-gear-side-0.4mm-flange.stl
rings/round-flanges/models-skinny/kraken-spool-ring-53-mm-round-cap-side-0.4mm-lip.stl
rings/round-flanges/models-skinny/kraken-spool-ring-53-mm-round-gear-side-0.4mm-flange.stl
rings/round-flanges/models-skinny/kraken-spool-ring-54-mm-round-cap-side-0.4mm-lip.stl
rings/round-flanges/models-skinny/kraken-spool-ring-54-mm-round-gear-side-0.4mm-flange.stl
rings/round-flanges/models-skinny/kraken-spool-ring-55-mm-round-cap-side-0.4mm-lip.stl
rings/round-flanges/models-skinny/kraken-spool-ring-55-mm-round-gear-side-0.4mm-flange.stl
rings/round-flanges/models-skinny/kraken-spool-ring-56-mm-round-cap-side-0.4mm-lip.stl
rings/round-flanges/models-skinny/kraken-spool-ring-56-mm-round-gear-side-0.4mm-flange.stl
rings/round-flanges/models-skinny/kraken-spool-ring-57-mm-round-cap-side-0.4mm-lip.stl
rings/round-flanges/models-skinny/kraken-spool-ring-57-mm-round-gear-side-0.4mm-flange.stl
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
