thereprocase/kraken-remix-ogAMS/prints/pctg-2026-10-28-v5/images/left-bar-only.png

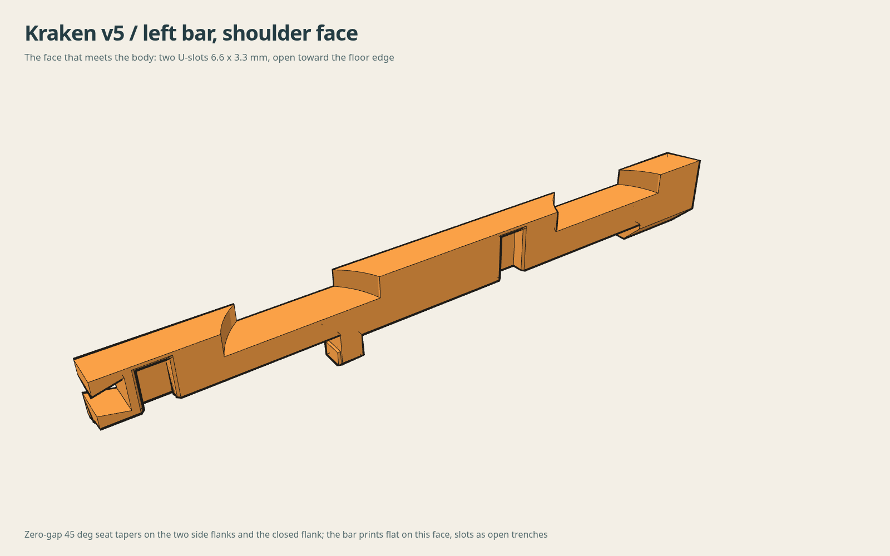
prints/pctg-2026-10-28-v5/images/left-bar-only.png
