thereprocase/kraken-remix-ogAMS/prints/pctg-2026-10-28-v5/images/right-firstlayer.png

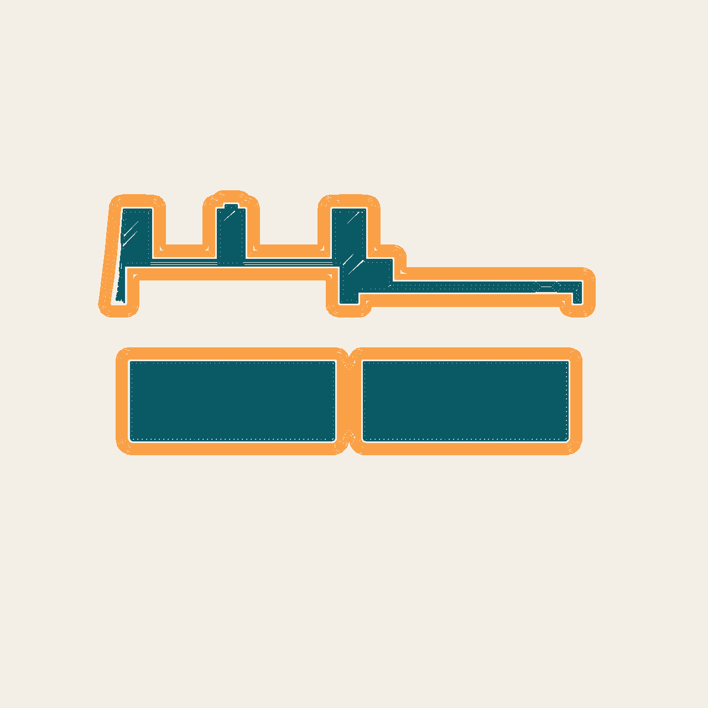
prints/pctg-2026-10-28-v5/images/right-firstlayer.png
