thereprocase/kraken-remix-ogAMS/prints/pctg-2026-10-28-v5/images/right-rear.png

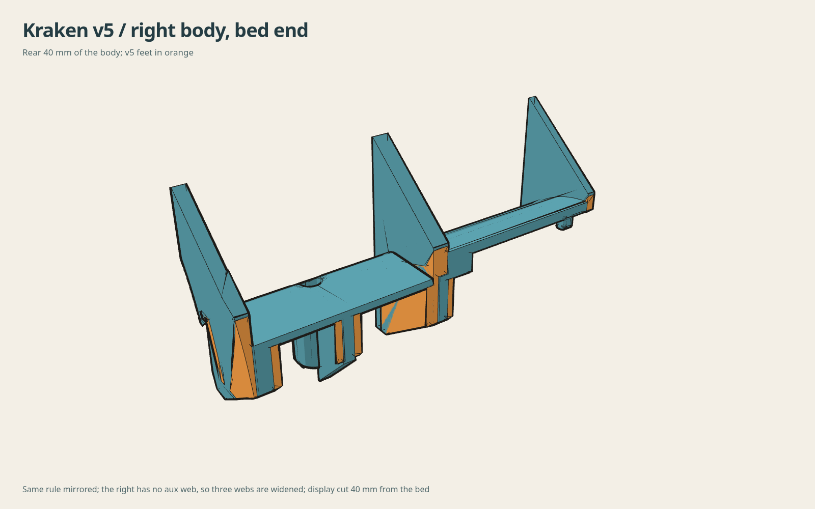
prints/pctg-2026-10-28-v5/images/right-rear.png
