thereprocase/kraken-remix-ogAMS/(commit log)

2026-10-15 Release accepted Kraken clearance-pocket cut5 bodies and front bars
    [left-body-pocket_cut5.3mf, left-body-pocket_cut5.step, left-front-bar-pocket_cut5.3mf, left-front-bar-pocket_cut5.step, right-body-pocket_cut5.3mf, right-body-pocket_cut5.step, right-front-bar-pocket_cut5.3mf, right-front-bar-pocket_cut5.step]
2026-10-15 Add eight-spoke spool gear with source and comparative validation
    [gear-spokes-analytic-web.step, gear-spokes.3mf, gear-spokes.stl, original-gear.stl]
2026-10-15 Publish existing pentagon spool flange pair with public download links
    [kraken-spool-ring-55.5-mm-pentagon-cap-side.stl, kraken-spool-ring-55.5-mm-pentagon-gear-side-1.5mm-flange.stl]
2026-10-15 Add validated faceted STEP solids for spool flange pair
    [kraken-spool-ring-55.5-mm-pentagon-cap-side.step, kraken-spool-ring-55.5-mm-pentagon-gear-side-1.5mm-flange.step]
2026-10-16 Publish body variants, fit coupons and pentagon pairs for every stock size
    [key_common.3mf, key_common.step, kraken-spool-ring-45-mm-100.3mf, kraken-spool-ring-45-mm-gear-side-1.5mm-flange.stl, kraken-spool-ring-45-mm-pentagon-cap-side.3mf, kraken-spool-ring-45-mm-pentagon-cap-side.stl, kraken-spool-ring-45-mm-pentagon-gear-side-1.5mm-flange.3mf, kraken-spool-ring-45-mm-pentagon-gear-side-1.5mm-flange.stl]
2026-10-16 Publish reinforced ASA body plates and assembly instructions
    [left-body-v4-model.3mf, machine.json, right-body-v4-model.3mf]
2026-10-17 Add reloadable Kraken refill spool prototype and validation evidence
    [added-parts-assembly.step, assembly-reference-NOT-FOR-PRINT.3mf, assembly-reference-NOT-FOR-PRINT.stl, backing-sleeve.3mf, backing-sleeve.step, backing-sleeve.stl, nut.stl, removable-flange.3mf]
2026-10-17 Add keyless refill sleeve and reinforce flange clamping annulus
    [backing-sleeve-keyless-installed.step, backing-sleeve-keyless.3mf, backing-sleeve-keyless.step, backing-sleeve-keyless.stl, removable-flange-stiff-annulus-installed.step, removable-flange-stiff-annulus.3mf, removable-flange-stiff-annulus.step, removable-flange-stiff-annulus.stl]
2026-10-17 Add uniform refill flange with deeper reinforcement and spaced tail holes
    [backing-sleeve-keyless-installed.step, backing-sleeve-keyless.3mf, backing-sleeve-keyless.step, backing-sleeve-keyless.stl, removable-flange-stiff-annulus-installed.step, removable-flange-stiff-annulus.3mf, removable-flange-stiff-annulus.step, removable-flange-stiff-annulus.stl]
2026-10-24 Add the 53.4 mm Elegoo pentagon pair and a size guide for popular cardboard spools
    [kraken-spool-ring-53.4-mm-pentagon-cap-side.3mf, kraken-spool-ring-53.4-mm-pentagon-cap-side.stl, kraken-spool-ring-53.4-mm-pentagon-gear-side-1.5mm-flange.3mf, kraken-spool-ring-53.4-mm-pentagon-gear-side-1.5mm-flange.stl]
2026-10-24 Link the browser ring, nut and gear generator
2026-10-28 Standardize ring flanges and add spring rings for hard plastic spools
    Every ring collection now ships a normal set (2.2 mm gear-side flange, 0.6 mm
    cap-side lip) and a skinny set (0.4 mm on both). humebeam's 0.4 mm cap lip breaks
    in bed removal and handling. generate_family.py thickens the source lip with
    thicken() and gains --set and --core; with the old 1.5 / 0.4 mm thicknesses it
    matches the earlier published pairs within 0.0016 mm3. Spring pairs (round
    spigot, four fingers) are for hard plastic hubs; pentagon pairs for cardboard.
    STEP.gz and bulk ZIPs move to release rings-2026-10-28.
    [kraken-spool-ring-45-mm-gear-side-1.5mm-flange.stl, kraken-spool-ring-45-mm-pentagon-cap-side-0.4mm-lip.3mf, kraken-spool-ring-45-mm-pentagon-cap-side-0.4mm-lip.stl, kraken-spool-ring-45-mm-pentagon-cap-side-0.6mm-lip.3mf, kraken-spool-ring-45-mm-pentagon-cap-side-0.6mm-lip.stl, kraken-spool-ring-45-mm-pentagon-cap-side.stl, kraken-spool-ring-45-mm-pentagon-gear-side-0.4mm-flange.3mf, kraken-spoo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]
2026-10-28 Add v5 bodies with square bed-end feet and drop-in front bars
    Bodies: the v4 printable-underside bodies plus a designed rear face. The native
    rebuild had given the end, middle and seam walls sloped leading edges that touch
    the bed on 1.4 mm pads; v5 gives each wall a square foot down to the support webs'
    corner-clearance line (front_support_y, 34.34 deg) and widens the webs and rib by
    3 mm per side at the bed with a 45 deg taper. Left bed face 2026 mm2 in one region
    (v4: 1415 in five islands), right 1516 (v4: 1016). Hardware 101/101 and 109/109 at
    0.05 mm, RFID gate, walls, masks, load strips and layer screen unchanged or PASS.
    Bars: same keys, U-slots open to the floor edge, 0.30 mm runnin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
    [left-body-v5-model.3mf, left-body-v5.step, left-front-bar-v5-assembly.step, left-front-bar-v5-model.3mf, left-front-bar-v5.step, right-body-v5-model.3mf, right-body-v5.step, right-front-bar-v5-assembly.step]
2026-10-28 Document the hardware slots in the v5 bodies and add the gap scan
    A gap scan of v5 against v4 (source/newgaps.py, closing radii 1.5 and 2.5 mm,
    restricted to within 2 mm of v5 additions) finds no new gap under 5 mm. The thin
    slots visible from the floor side are the RFID board slot, the main-board edge
    tab slots, the box clip slot, the rib screw clearance, the hub post bores, the
    feeder sockets, the roller seat mouths and the right ferrite rails, all present
    in v4 and in the original design.
2026-10-28 Close the two tub-side slots in the v5 bodies
    Owner's slice review found a 2.65 mm slot beside the middle support web and
    a 2.3 mm slot beside the seam-wall toe, both open to the tub floor and both
    carried over from v4. The web is widened to the cap-bay wall face from the bed
    end to 5 mm before the RFID pocket entry; the seam wall is filled beside its toe
    from Y 44 down to the 1.4 mm floor relief over the seam support run. All checks
    rerun: hardware 101/101 and 109/109, revalidation, walls, masks unchanged, RFID
    gate, load paths (fill zones reported), layer screen, deviation gate PASS on both
    sides, test slices 10 h 37 min / 10 h 34 min.
    [left-body-v5-model.3mf, left-body-v5.step, right-body-v5-model.3mf, right-body-v5.step]
2026-10-28 Publish the v5 PCTG sliced projects and release links
    Left and right bodies sliced at 0.3 mm with 60 mm/s outer walls in the
    3D-Fuel Pro PCTG Matte preset; release pctg-print-2026-10-28.
